freetserv/freetserv/BOM.txt

Qty Value            Part Num         Package               Parts                                                                                                                                                                                                                                                                                                                                                                                                                                                                                                       
1                    A1921-ND         1X02                  PWRIN                                                                                                                                                                                                                                                                                                                                                                                                                                                                                                       
95  0.1uF            1276-1003-1-ND   C0805                 C1, C4, C11, C12, C15, C16, C17, C18, C19, C22, C23, C24, C25, C26, C27, C28, C29, C30, C31, C32, C33, C34, C35, C36, C37, C38, C39, C40, C41, C42, C43, C44, C45, C46, C47, C54, C55, C56, C57, C58, C59, C60, C61, C62, C63, C64, C65, C66, C67, C68, C69, C70, C71, C72, C73, C74, C75, C76, C77, C78, C79, C80, C81, C89, C90, C91, C92, C93, C94, C95, C96, C97, C98, C99, C100, C101, C102, C103, C104, C105, C106, C107, C108, C109, C110, C111, C112, C113, C114, C115, C116, C489, C519, C859, C869
2   1.5K             311-1.5KARCT-ND  R0805                 R3, R6                                                                                                                                                                                                                                                                                                                                                                                                                                                                                                      
1   1uF              311-1365-1-ND    C0805                 C5                                                                                                                                                                                                                                                                                                                                                                                                                                                                                                          
3   3.3uF            445-7589-1-ND    C0805                 C8, C629, C829                                                                                                                                                                                                                                                                                                                                                                                                                                                                                              
6   4.7uF            1276-2972-1-ND   C0805                 C13, C14, C53, C502, C879, C889                                                                                                                                                                                                                                                                                                                                                                                                                                                                             
1   6MHz             535-10208-1-ND   CSM-7X-DU             Q2                                                                                                                                                                                                                                                                                                                                                                                                                                                                                                          
1   10k              311-10KARCT-ND   R0805                 R5                                                                                                                                                                                                                                                                                                                                                                                                                                                                                                          
4   10uF             490-10517-1-ND   C0805                 C2, C3, C6, C7                                                                                                                                                                                                                                                                                                                                                                                                                                                                                              
3   12K/1%           311-12.0KCRCT-ND R0805                 R2, R13, R15                                                                                                                                                                                                                                                                                                                                                                                                                                                                                                
1   15uH             587-2624-1-ND    NR60XX                L3                                                                                                                                                                                                                                                                                                                                                                                                                                                                                                          
2   18pF             709-1171-1-ND    C0805                 C20, C21                                                                                                                                                                                                                                                                                                                                                                                                                                                                                                    
1   22K              311-22KARCT-ND   R0805                 R7                                                                                                                                                                                                                                                                                                                                                                                                                                                                                                          
2   27               311-27ARCT-ND    R0805                 R1, R8                                                                                                                                                                                                                                                                                                                                                                                                                                                                                                      
1   27               Y2270CT-ND       EXBV4V                RN2                                                                                                                                                                                                                                                                                                                                                                                                                                                                                                         
1   31.6k            311-31.6KCRCT-ND R0805                 R4                                                                                                                                                                                                                                                                                                                                                                                                                                                                                                          
6   330              490-5988-1-ND    WE-KI_0805A           FB1, FB2, FB2\, FB2\1, FB2\2, FB3                                                                                                                                                                                                                                                                                                                                                                                                                                                                           
12  3232             296-19263-1-ND   SOP65P640X120-16N     IC5, IC6, IC7, IC8, IC10, IC11, IC12, IC13, IC15, IC16, IC17, IC18                                                                                                                                                                                                                                                                                                                                                                                                                                          
1   0446200001       *                0446200001            X1                                                                                                                                                                                                                                                                                                                                                                                                                                                                                                          
1   61300411021      732-5337-ND      61300411021           DAISY_OUT                                                                                                                                                                                                                                                                                                                                                                                                                                                                                                   
1   613004143121     732-2863-ND      613004143121          DAISY_IN                                                                                                                                                                                                                                                                                                                                                                                                                                                                                                    
1   ASFL1-12.000     535-9253-1-ND    XO53                  QG1                                                                                                                                                                                                                                                                                                                                                                                                                                                                                                         
3   FT4232HL         768-1026-1-ND    LQFP64                FTDI1, FTDI2, FTDI3                                                                                                                                                                                                                                                                                                                                                                                                                                                                                         
1   MCP16311         MCP16311-E/MS-ND MSOP8                 IC1                                                                                                                                                                                                                                                                                                                                                                                                                                                                                                         
2   MOUNT-HOLE3.2    *                3,2                   H1, H2                                                                                                                                                                                                                                                                                                                                                                                                                                                                                                      
2   SN65220          296-9694-1-ND    SOT23-6               D1, D2                                                                                                                                                                                                                                                                                                                                                                                                                                                                                                      
1   SS73100-046F_DWG 380-1225-ND      SS73100-046F          U$1                                                                                                                                                                                                                                                                                                                                                                                                                                                                                                         
1   TUSB2046BVF      TUSB2046BVF      QFP80P900X900X145-32N HUB                                                                                                                                                                                                                                                                                                                                                                                                                                                                                                         
1   USB_MICROB       H11634CT-ND      USB_MICROB_PACKAGE    USB_HOST
