freetserv/freetserv/(threads)

Thread 4 (2015-09-19):

increase spacing around U1 if possible

stapelberg, 2015-09-19:

stapelberg, 2015-09-26:
I think with #3 fixed, the spacing should be okay. Given that the design works fine (+5V goes in, +3.3V comes out), I’m a bit hesitant to change it unless absolutely necessary.

Closed 2015-09-26.

Thread 5 (2015-09-19):

swap TLV810 with TLV803, gets rid of the inverter

stapelberg, 2015-09-19:

stapelberg, 2015-09-22:
We’ll need a pull-up resistor for this.

stapelberg, 2015-09-26:
Or, even better, just use an R/C circuit, which saves half a euro per board (and one IC which is hard to solder).

Closed 2015-09-26.

Thread 12 (2015-09-22):

The 3 100nF capacitors near VCORE are missing (to clean the voltage)

stapelberg, 2015-09-22:

Closed 2015-09-28.

Thread 6 (2015-09-22):

Add resistors and capacitors for USB impedance

stapelberg, 2015-09-22:

stapelberg, 2015-09-28:
From http://www.ti.com/lit/ds/symlink/tusb2046b.pdf:

> All USB DP, DM signal pairs require series resistors of approximately 27Ω to ensure proper termination. An optional filter capacitor of about 22 pF is recommended for EMI suppression. This capacitor, if used, must be placed between the hub terminal and the series resistor, as per section 7.1.6 of the USB specification.

stapelberg, 2015-09-28:
Going to use 311-27.0CRCT-ND (RES SMD 27 OHM 1% 1/8W 0805)

Closed 2015-09-28.

Thread 15 (2015-09-24):

clone layout 3 more times once done

stapelberg, 2015-09-24:
Use https://github.com/esawdust/eagledroppings

stapelberg, 2015-09-24:
Use Eagle’s Hierarchical Design capabilities beforehand in the schematic so that it’s easier to understand the schematic, provided the free version can do that.

stapelberg, 2015-11-08:
This is done with commit 2a5ee336e396ece85858b84dca2a15ba39bcd74f

Closed 2015-11-08.

Thread 16 (2015-10-17):

Figure out a suitable 19" case

stapelberg, 2015-10-17:
Current candidates:

• [Rack case from RS](http://ch.rs-online.com/web/p/gehause-rackmontage/6657706/) (for 55 CHF), requires aluminium front panel processing
• [Schaeffer AG](http://www.schaeffer-ag.de/en/products/housings/) could make a case + front panel (or just a front panel, for the RS case?)

stapelberg, 2015-10-17:
We’ll also need a 5V/2A open frame power supply.

stapelberg, 2015-10-17:
[Delta Electronics PJ-5V15WBNA](http://www.digikey.ch/product-detail/de/PJ-5V15WBNA/1145-1060-ND/4386531) seems to be the best fit for an open frame power supply (5V 3A).

stapelberg, 2015-10-17:
Based on a bit of playing around with Schaeffer AG’s Frontplatten Designer, making a 19" case (with custom front panel and screw holes where we need them) costs about 200 €.

stapelberg, 2015-10-17:
To connect a power cable to the PSU, another device uses [the Delta 03KENG3EA](https://www.digikey.com/product-detail/en/03KENG3EA/1144-1118-ND/4379979), but I’m not sure if there isn’t a better choice.

stapelberg, 2015-11-09:
http://www.digikey.ch/product-detail/de/PJ-5V15WCNA/1145-1061-ND/4386532 is the enclosed version of the power supply mentioned above.

stapelberg, 2015-11-21:
Here’s what one needs to order at Schaeffer (as a note for me until we describe it on the website):

* 1 x file:back.fpd
* 1 x file:front.fpd
* 1 x file:top.fpd
* 1 x file:bottom.fpd
* 2 x GLGP1011 Seitenprofil 1, natur eloxiert, Länge: 150,0 mm
* 1 x GGMS1102 Montageset ISP/B3,0-ZI DIN 7982, weiß verzinkt
* 1 x GGWS0111 Gehäusewinkel (4 Stück), natur eloxiert

stapelberg, 2015-12-08:
1144-1140-ND (Delta 03GENW3E-R) is a power inlet which includes wires, which is a bit more convenient.

Closed 2015-12-24.

Thread 17 (2015-11-20):

wrong part/wrong package: QG1

stapelberg, 2015-11-20:
The actual part is too big to be soldered onto the board. Need to find a different part or fix the packaging.

Closed 2015-11-20.

Thread 18 (2015-11-21):

enhancement: use a different oscillator

stapelberg, 2015-11-21:
Currently, QG1 is a 12MHz SMD oscillator, which is rather expensive in this form factor (2.47€ at digikey) and hard to solder when hand-soldering. For the next revision, we should chose a bigger and less expensive oscillator.

Closed 2015-11-30.

Thread 20 (2015-11-25):

case: revision 2

stapelberg, 2015-11-25:
- [x] use the right deployment option for the PSU (the left one obscures the fan and the micro USB port)
- [x] move PSU 2cm to the right, so that the case’s left hole for the angle is not obscured. This implies moving the Raspberry Pi to the right.
- [x] ensure the PSU has 4mm safety distance from all components
- [x] fix dimensions for the power inlet (currently uses the *outer* dimensions, should use the “suggested mounting cut-out” dimensions from the [datasheet](http://www.deltaww.com/filecenter/Products/download/04/0406/iec_inlet_filter/KEN.pdf))
- [x] make case 2cm deeper so that the holes for the angles can be used.
- [x] ensure there are 16mm of space from the top of the PCBs, so that we could connect each one via USB in case daisy-chaining does not work.
- [x] in the front, move the space where the bottom/top slides into 1mm up/down (for bottom/front, respectively). This reduces the space in our case by 2mm, but makes sure that we can actually slide in the front/bottom plates, making the entire construction more robust.
- [x] add 2mm of material to the top/bottom plate, so that it can slide into the front panel
- [x] label the serial ports, label eth0
- [x] label power inlet with 230V / 15W (PSU specs)
- [x] move the third PCB 0.5mm to the left
- [x] move the second PCB 1mm to the left
- [x] move the first PCB 1.5mm to the left
- [x] check if it is easy to add a power LED
- [ ] use a side profile which is 20mm longer than previously

notes: 3.5mm of extra height is available in the case currently, but try to use only 3mm of extra height to play it safe. At the bottom, we have 2mm of space until the parts on the PCB touch the bottom of the case.

Closed 2015-11-27.

Thread 21 (2015-11-25):

document errate on website

stapelberg, 2015-11-25:
- [x] solder 8P8C ports onto first board
- [x] test all serial ports for sending/receiving
- [x] hook up boards to the raspberry pi, verify that it recognizes them
- [x] solder another board
- [x] test whether the daisy chaining works: it doesn’t. commit f99ddb0e3210b0f54aaaec5ce0b93b40c5a6e815 fixes it (hotfix is to solder a wire to the nearest GND)

stapelberg, 2015-12-19:
Closing this as we don’t need an errata section now — the only published version is 1.2.

Closed 2015-12-19.

Thread 22 (2015-11-25):

re-order missing/wrong parts

stapelberg, 2015-11-25:
- [ ] 5-position header for the PSU: 455-1186-ND
- [ ] 5V power LED: 67-1100-ND

stapelberg, 2015-11-29:
Ordered.

Closed 2015-11-29.

Thread 24 (2015-11-25):

clean up silkscreen

stapelberg, 2015-11-25:
The part names are not very useful when soldering, we should switch to values for capacitors and resistors.

We should also pay a lot more attention to where the labels end up — a number of labels are not visible on the current silkscreen.

stapelberg, 2015-11-30:
We also need to enable the tValues and bValues layer in the CAM job file.

Closed 2015-11-30.

Thread 26 (2015-12-06):

enhancement: create a header for the ethernet port

stapelberg, 2015-12-06:
We can just not populate it on 3 of the 4 boards.

jaredmauch, 2016-01-03:
I can tackle this one.  It's super simple.

stapelberg, 2016-01-04:
Great, looking forward to your pull request (please keep the changes as small as possible). Let me know if you need anything.

jaredmauch, 2016-01-04:
Well, I haven't completed it, but thought I'd ask your feelings on this placement first before I fix all the impacted traces, length matching, etc.

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

stapelberg, 2016-01-04:
Thanks for the preview. I think the general position is fine, especially since the daisy-chain connector on the right hand side does not need to be populated for the right-most board.

Here are a couple of thoughts:

* Is the part that you’re adding available on Digi-Key?
* Can you come up with a way to route it without touching any other traces to make this change as non-invasive as possible? It looks to me like it might be possible to use traces on the top layer that go from top to bottom on the right hand side of the PCB, all the way to P12.

jaredmauch, 2016-01-04:
Yes, it's available on Digikey (WM5467-ND) and there are other variants which are more expensive or cheaper, eg: WM5468-ND which are pin compatible.  It's not really possible without moving part D2, which I assume is ok.  The traces related to D2 have to be re-routed.  This would obviously impact anyone using a PnP machine to place parts.

Is there a common .lbr file for freetserv I should put these parts in, or should that go in the pull?  I could also just email you the files offline.

stapelberg, 2016-01-04:
Moving D2 is okay. We don’t have a common .lbr file yet, but you’re welcome to start one, or just let Eagle embed the lbr file into the brd/sch files as appropriate (which is what we currently do).

jaredmauch, 2016-03-03:
taking a fresh look at this, i'm concerned that having the ethernet pin 5 shared with the RS232 ground may cause signal issues, have you had issues with the soldered cable connection being shared with the uart12 level shifter?

jaredmauch, 2019-12-18:
since this was merged, should this be closed?

stapelberg, 2019-12-19:
Yep, thanks

paravoid, 2020-12-20:
I've noticed that the documentation (assembly.html) still documents a manual way, and references this issue as a work-in-progress. Not sure how this should be updated though.

stapelberg, 2020-12-20:
@jaredmauch Any thoughts on this? Personally, I don’t have a build with the new ethernet port solution, and don’t plan on building one right now.

Closed 2019-12-19.

Thread 27 (2015-12-07):

case: top plate has cut-outs the wrong way around

stapelberg, 2015-12-07:
…that’s important because the screw holes are sunk, and it doesn’t look as good as-is ;)

Closed 2015-12-07.

Thread 29 (2015-12-07):

case: front panel is too thick for the power filter to snap in

stapelberg, 2015-12-07:
According to [the datasheet](http://www.deltaww.com/filecenter/Products/download/04/0406/iec_inlet_filter/KEN.pdf), we’ll need to cut out 1.5mm worth of aluminum for about 1mm at the top and bottom each.

stapelberg, 2015-12-08:
To fix it, we can drill a 4.5mm (height) x 23mm (width) x (3-1.2)mm (depth) rectangle at the top and bottom of the inlet cutout hole.

One other thing to investigate is to use an inlet that is secured by screws instead of a snap-in one — we have the space, and using screws should be more reliable.

Closed 2015-12-10.

Thread 30 (2015-12-07):

case: LED shows out too much

stapelberg, 2015-12-07:
We should probably switch to an SMD LED and add a relatively flat diffusor or something. As-is, when you place the case such that the LED is on the bottom, all the weight is on the LED, which makes it hard to fix the LED with hot glue.

stapelberg, 2015-12-11:
A 3.3kΩ with 1497-1017-ND (3.3V LED) seems to work pretty well in terms of brightness and current (<10mA, so should be okay for the Raspberry Pi’s GPIO).

stapelberg, 2015-12-11:
We should change the case to be 1mm less thick where the LEDs are, though, so that the shorter LEDs can actually go through the hole.

Thread 31 (2015-12-07):

Document raspberry pi set up on the website

stapelberg, 2015-12-07:
* [x] install the usual programs for serial port access (cu, minicom, screen, what else? check alix history)
* [x] make the system read-only
* [x] disable DHCP for IPv4, the device is going to be IPv6-only
* [x] set up permissions for ports via udev rules. see issue #25
* [x] recommend users to use the “from” directive in their `~/.ssh/authorized_keys`, to limit logins to certain IP addresses
* [x] watchdog LED: add configuration which will configure GPIO4 as an output and make it blink, signaling that the device is still alive. GPIO4 is a good choice because it is right next to GND, see http://www.raspberrypi-spy.co.uk/2012/06/simple-guide-to-the-rpi-gpio-header-and-pins/. With http://int03.co.uk/blog/2015/01/11/raspberry-pi-gpio-states-at-boot-time/, we might be able to configure it as a high output by default
* [x] MOTD file

Closed 2015-12-24.

Thread 33 (2015-12-08):

case: bottom plate’s holes are sunk the wrong way

stapelberg, 2015-12-08:
Need to place them on the backside of the plate.

Closed 2015-12-10.

Thread 34 (2015-12-09):

nit: figure out if we can change the schematics in such a way that the daisy_in on the last board can be disabled

stapelberg, 2015-12-09:
Currently, there is a USB enumeration error in the syslog, which comes from the fact that one USB device is not connected. I wonder if we can get rid of that easily.

Thread 35 (2015-12-24):

nit: find correctly colored cable (green/yellow) for grounding

stapelberg, 2015-12-24:
Currently, we use Digi-Key A119543-ND, but that doesn’t have the right color. Find a cable with the correct size and color.

athompso, 2019-07-15:
As of 2019jul15, DigiKey has 38 options to choose from that are "Normally Stocking":  https://www.digikey.com/products/en/cables-wires/single-conductor-cables-hook-up-wire/474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

The problem is that they all start at 100' (30m).

I checked Mouser, and they have the same problem - lots of options https://www.mouser.ca/Wire-Cable/Hook-up-Wire/_/N-5ggsZscv7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|0 assuming you want 100' or more.

Any local electronic or auto-parts supply store will have similar options; in the auto industry this is "primary wire", and often comes in rolls as small as 25'.  Or, just ask your local mechanic for a length of 18ga, green primary wire and it'll probably be free.  (Note that primary wire is often solid copper, though, not stranded.)
Higher gauges are usually OK for a grounding wire, and that increases your options, for example anywhere in Canada you can order this ridiculously cheaply: https://www.princessauto.com/en/detail/16-gauge-25-ft-green-primary-wire/A-p8216475e

If in the USA, you can find this nearby: https://www.homedepot.com/p/Southwire-25-ft-16-Green-Stranded-CU-GPT-Primary-Auto-Wire-56422021/202316507

I've no idea what to get in Europe, but I'm sure something similar exists - certainly mechanics and electricians are not noticeably more rare there than here in Canada, so shops must exist to service them.

I hate to encourage bad practice, but it would probably be cheaper and easier to destroy a standard PC power lead and scavenge 3ft of green-jacketed, stranded-copper, ground wire from that :-(.

athompso, 2019-07-15:
Also viable, but PITA: wrap colored electrical tape around the wire and/or use green heat-shrink tubing.

stapelberg, 2019-07-16:
Thanks for the details, that’s very helpful!

Thread 37 (2015-12-29):

Case redesign suggestions

alexandrujuncu, 2015-12-29:
Hi!

Just throwing in a couple of cents on the hardware design, if you find it helpful:
1) From what I understand from the pictures, it looks like the first RJ45 port is actually an Ethernet port while all the others are serial ones. This is both confusing and dangerous if somebody confuses the ports might end up burning the port (serial and Ethernet are not electrically friendly and I've seen a lot of people destroying ports because they plugged in the wrong one).
I think the Ethernet port should be clearly separated from the others. Also it might be better to NOT use an extender and just have the RJ45 port from the RPI directly accessible. Which brings me to the next point...
2) The Raspberry Pi board should not be the middle of the box, but at the edge accessible to the user. This way the side with the RJ port and the 2/4 USB ports would be accessible to the use. The USB ports could be used for miscellaneous things for the user so why not expose them?
But where to pace it? It will take up some room in the front. So the logical solution is instead of the power plug. And, again, this brings me to another point:
3) The power plug should not be in the front. I have seen many racks with many routers, switches and servers and with very few exceptions (I remember some annoying Cisco ASA/PIX-s) equipment has the power plug in the back. As it should. Power is provided through the back to be consistent with the rest of the equipment and also not block rack door from closing (power plugs tend to take up more room).

So, in conclusion, I suggest you put the Raspberry Pi on the left of the console ports, in the front. This way you would separate the Ethernet port from the serial ports and have direct access to the Ethernet and USB ports on the board itself. The big power plug could and _should_ be put in the back where it belongs and not get in the way of anything else.

Hope this helps. Thanks!

stapelberg, 2015-12-29:
The front side of freetserv has the serial ports and the power plug on the same side because servers do the same thing (see e.g. https://images.stockinthechannel.com/pic/-pie3aUTqUmBmdYcnONR9A.c-o.jpg). This leads to all the cables being on the same side of the rack, i.e. less clutter and less long cables.

If one wants to go for a case where some parts are on the front side and some are on the back side, I think it’d be reasonable to place the Raspberry Pi’s ports facing the back side, so that one gets the benefits of having the Ethernet port directly accessible that you mentioned. One tiny side node on the USB ports, though: freetserv is intended to be a single-purpose device, so there shouldn’t be a need to use the USB ports, or at least not in any user-facing fashion.

In general, I don’t have strong feelings on the way the case is designed. The current design works very well for the use-case that I’m solving for myself, and I’m publishing the files because they’re tested and found working. If other people have other use-cases/preferences, they’re welcome to modify the fpd files before ordering the case (or build an entirely new case altogether), and I’m happy to accept these modifications to live in the same repository. The only thing I ask is that such modifications are actually tested, and not just theoretical :).

I’ll close this issue as nothing remains to be done, at least not from my side. Thanks for your input!

alexandrujuncu, 2015-12-30:
Hi!

That image is actually actually backs the idea that power plugs should be at the back :-?

I've never worked with software to design hardware, so I might not be the right person for that.
But, perhaps, if you leave the issue open, someone in the community has the skills to do it.

Thanks!

stapelberg, 2015-12-30:
I think you are making the assumption that freetserv gets plugged into the front of the rack, i.e. the side where all the server LEDs are. The idea is to plug it into the back of the rack, though, where all the serial console ports, network cables and power cables are. Hence, freetserv’s front side is in the rack’s back side. I can add an actual picture of our rack in the next weeks.

Closed 2015-12-29.

Thread 40 (2016-06-15):

PCB fab details

rich86, 2016-06-15:
I have never had a PCB fabbed before, nor do I have the requisite software to open and view the files, for people like me, it would be helpful if there could be a little bit more hand-holding whilst ordering from from Smart Prototyping - I haven't yet placed an order because I'm not sure of which options I need to change.

A screenshot or a list of options on the materials.html would be very useful.

Also, are there any obvious gotchas that people should be aware of if they order from another fab, such as OSH Park?

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

stapelberg, 2016-06-22:
Thanks for your interest in the project.

> I have never had a PCB fabbed before, nor do I have the requisite software to open and view the files, for people like me, it would be helpful if there could be a little bit more hand-holding whilst ordering from from Smart Prototyping - I haven't yet placed an order because I'm not sure of which options I need to change.

If you have never had a PCB fabbed, I have to ask: are you aware that SMD soldering is not a trivial task? If you haven’t done it before, you should definitely get a bunch of starter kits and train. The critical components on freetserv are 4 bucks a piece (for the FTDI), and messing up one of them will very likely render the entire board unuseable, which is a big waste of money and source of frustration :).

With that out of the way, here are the parameters I used:

```
PCB Prototyping
  - Quantity: 10
  - Max X-Dimension (cm): 10
  - Max Y-Dimension (cm): 10
  - Layers: 2
  - PCB Thickness (mm): 1.6
  - Copper Thickness: 1 oz
  - Surface Finish: HASL (Hot Air Solder..
  - Solder Mask Color: Green
  - E-Test Pass: 100%
  - Solder Paste Stencil: no
  - Separated Sub-Boards: no
  - Lead Time: Normal
  - Gerber Files(zip or rar): gerber.zip
```

So, everything left to the default setting, except for the E-test being raised to 100% and the X/Y dimension adjusted because our PCB is bigger than 5cm x 5cm.

Hope that helps.

paravoid, 2020-12-20:
Piggybacking on this issue… a good option would be to use JLCPCB's SMT assembly service. I spot-checked a lot of the ICs and they all seem to be in their SMT parts library. The exact part numbers for some of the more standard components (capacitors etc.) don't match, but of course replacements exist. It shouldn't be too hard to create a BOM!

Note that they currently don't support connectors (like USB) but that's supposedely imminent. They also do not support through-hole components, but these are also easier to solder. Just having all the SMT components sourced and soldered would lower the bar here considerably IMHO :)

paravoid, 2020-12-20:
So I looked into it a bit more: 5 components (incl. the FT4232 and MAX3232) are available and 13 have a direct replacement from another vendor (same characteristics/package). On the flip side, 4 don't have a direct replacement (ferrite beads, 6MHz crystal, resistor array, HC-49/US inductor), 5 are through-hole components (RJ45 jacks, and board-to-board connectors) that are not supported but are also easy to solder, plus one SMT connector (microUSB) that is rumoured to be soon available for assembly.

More importantly though… JLCPCB's service doesn't support SMT assembly on both sides of the PCB, and the current design has the components almost equally split between the two sides as far as I can tell. So unless they add support for two-sided assembly, or someone is willing to go through the pain of a PCB redesign here, I don't see a lot of value in pursuing this further…

Thread 41 (2016-10-08):

Wrong Digikey Part for QG1

jhorisberger, 2016-10-08:
The 12MHz Oscilator in the BOM from eagle and on the Homepage dos not fit the footprint on the PCB. From the Silkscreen on the PCB i gather that it should be form the ASFL1 series (instead of ASV). I found this part:  Abracon LLC ASFL1-12.000MHZ-EK-T (535-9253-1-ND ) which I think should be ok? (almost identical specs and right footprint)

stapelberg, 2016-10-19:
Thanks for reporting this. I just had a chance to check my inbox for orders, and indeed I did order the 535-9253-1-ND after I must have realized that the other oscillator has the wrong form factor :).

I’ll fix this in a second.

Closed 2016-10-19.

Thread 42 (2017-08-20):

BOM DAISY_IN Digi-Key Part 732-2863-ND is a 10 pin Header

lairsdragon, 2017-08-20:
Hi

The Digi-Key Part Number 732-2863-ND is a 10 pin Header. The Wurth Elektronik part number in the BOM.txt is correct but I was not able to find that part at Digi-Key.

The Wurth Elektronik part number on the  website (in fts-bom-pcbparts.html) is wrong.

cheerio
    Steve

stapelberg, 2017-08-20:
Thanks! This is now fixed.

lairsdragon, 2017-08-20:
Hi Michael

The Digi-Key Part Number points still to a 10 pin Header;

cheerio
    Steve

stapelberg, 2017-08-20:
I can’t find a more suitable part number on Digi-Key. You can easily cut the 10-pin connector to be a 4-pin connector, so it’s no big deal. If you have a better part number, let me know.

Closed 2017-08-20.

Thread 43 (2018-09-16):

known issue: some serial ports are broken on my build

stapelberg, 2018-09-16:
Out of the 47 serial ports, 3 don’t give any signal when connecting devices:

- port 24
- port 43
- port 45

This might well be a problem with my soldering, but I figured it makes sense to document it here. Unfortunately, I lack the opportunity to debug this particular build.

Thread 44 (2018-09-16):

known issue: sometimes, all ports stop working until a reboot

stapelberg, 2018-09-16:
I ran into this situation twice (I think) with my one build.

At a certain time — I’m not sure when — all ports stop working. The FTDI driver prints messages to syslog, but unloading and reloading the driver seems to have no effect.

Rebooting the device seems to help. I haven’t tried reloading the USB stack, as the issue is so rare.

Thread 46 (2020-05-15):

udev rules not working on Raspi 4

r-schmidt, 2020-05-15:
On the Raspi 2 the USB ports were identified as platform-bcm2708_usb-usb-[0-9] in freetserv.rules.
The Raspi 4 is a different platform so that fails. Instead the name is now platform-fd500000.pcie-pci-0000:01:00.0-usb-[0-9].

I made a little script that creates the rules file from a template:

`#!/bin/sh`

`rules_template_file="/usr/local/freetserv/freetserv.rules.template"`
`rules_file="/etc/udev/rules.d/freetserv.rules"`

`# create udev rules based on template file:`
`# find the ID of the USB port the PCBs are connected to`
`pcb_usb_port=$(udevadm test-builtin path_id /sys/class/tty/ttyUSB0 | grep -Po 'ID_PATH=\K.*usb-[0-9]?')`

`sed "s/FREETSERV_USB_PORT/$pcb_usb_port/g" "$rules_template_file" > "$rules_file"`

` # trigger update of the device name symlinks`
` for i in $(seq 0 47); do udevadm test $(udevadm info -q path -n /dev/ttyUSB$i) >/dev/null 2>&1; done`

The template is simply the existing freetserv.rules file where `platform-bcm2708_usb-usb-[0-9]`
if replaced with `FREETSERV_USB_PORT` which the script then replaces with the actual port.

stapelberg, 2020-05-15:
Thanks for filing this. Could you send a pull request which updates https://github.com/freetserv/freetserv/blob/05c33bea87f1ace5e6dc063f59996f533559ec67/udev/freetserv.rules please? I don’t mind duplication in there, and the file changes rarely.

By the way: did you build a freetserv instance? How is everything working out for you?

stapelberg, 2020-05-15:
This is fixed with pull request PR #47

r-schmidt, 2020-05-15:
I'm totally new to Github so I hope I did the pull request right (or not completely wrong...).

My freetserv instance is quite different because the use case is very different:
I have shelves (with line cards) with serial ports from every slot combined into ribbon cables (12 slots per cable) for debugging.
So the PCB was modified with a pin header for the ribbon cable which connects to the different RJ45 soldering points and the RJ45 sockets are not assembled.
The front plate only contains one RJ45 socket for the Ethernet of the Raspi, a LED to see that power is on, power connector and a power switch.
The back plate has openings for 4 ribbon cables so I can connect 2 fully equipped shelves (48 slots).
The case is a really cheap plastic one: https://www.reichelt.de/19-rack-gehaeuse-1-he-abs-schwarz-rnd-455-00114-p193326.html?&trstct=pol_1&nbc=1
The front and back plate are replaced with 3D-printed ones for the connectors and switch (could also make holes in the existing plates but printing is cool...).

On the raspi I used raspian (Debian is not there yet for proper out of the box use on raspi 4).
There is a single passwordless user that all telnet connections log into. The serial port is selected by giving the name to telnet as user name (parameter -l) instead of the port number like in the commercial terminal servers.
I had to change /etc/pam.d/common-auth to allow login without password (nullok instead of nullok_secure).

Using SSH would have meant to provide everyone with the same private key or add many public keys to the user. Or have many users like what you use which is also not feasible for us.
It is a development tool and which slot is used by whom can change multiple times per day and there are also multiple users looking at the same port.

After login the provided username is used to select which screen instance to attach to. This makes management really simple.
And it allows to use aliases for the ports without having to add more symlinks via udev.
I'm not completely done with that yet (e.g. managing aliases with a simple management interface is on the todo list).

stapelberg, 2020-05-15:
Sounds great, thanks for sharing! Do you have any pictures? I’m glad to learn that freetserv was useful for your project.

Your pull request was fine, too! :)

Closed 2020-05-15.

Thread 48 (2020-12-16):

using more than 34 ports at the same time crashes the kernel

r-schmidt, 2020-12-16:
This is obviously a bug/limitation in Linux but I just wanted to mention it here.
I'm using screen to access the serial ports and leave the sessions running so I can re-attach later.
Now I saw that the moment I create the 35th session, the kernel crashes.
It doesn't matter which port the session is created for.

I'm using the latest Raspberry Pi OS on a Raspi 4B with 2GB RAM and the issue is reproducible every time and on all of my 48 port freetservs.

I was just wondering if you also see that on your system that unless you changed it is running a Debian?

stapelberg, 2020-12-16:
Thanks for documenting this issue.

I haven’t run into this myself because we never had that many sessions on freetserv.

Perhaps you can raise this on the Linux kernel mailing list and see if anyone can help there?

raylee, 2020-12-16:
@r-schmidt could you post the kernel's oops message from the crash? Even an image would be helpful, though the complete oops in text form is preferred. You'll want that for posting to the linux kernel mailing list regardless.

r-schmidt, 2020-12-17:
Ok, here is what is coming on the console (there is more coming every ~30 seconds but that is probably irrelevant).
I haven't tried connecting the ports to a different computer (e.g. my notebook) to see if it happens there as well.
Will maybe do that later today.

[  103.715803] 8<--- cut here ---
[  103.720089] Unhandled fault: asynchronous external abort (0x1211) at 0x00000000
[  103.728619] pgd = d30b99fe
[  103.732532] [00000000] *pgd=17787003, *pmd=00000000
[  103.738634] Internal error: : 1211 [#1] SMP ARM
[  103.744388] Modules linked in: sha256_generic libsha256 cfg80211 rfkill 8021q garp stp llc ftdi_sio usbserial vc4 cec rpivid_mem v3d drm_kms_helper gpu_sched drm bcm2835_codec(C) bcm2835_v4l2(C) bcm2835_isp(C) v4l2_mem2mem bcm2835_mmal_vchiq(C) videobuf2_dma_contig videobuf2_vmalloc videobuf2_memops videobuf2_v4l2 videobuf2_common drm_panel_orientation_quirks raspberrypi_hwmon snd_soc_core videodev mc vc_sm_cma(C) snd_compress snd_pcm_dmaengine snd_pcm snd_timer snd syscopyarea sysfillrect sysimgblt fb_sys_fops uio_pdrv_genirq uio ip_tables x_tables ipv6
[  103.797884] CPU: 0 PID: 2336 Comm: sudo Tainted: G         C        5.4.79-v7l+ #1373
[  103.807232] Hardware name: BCM2711
[  103.812161] PC is at lockref_put_return+0x50/0x9c
[  103.818379] LR is at dput.part.8+0x58/0x3b8
[  103.824052] pc : [<c06a2f98>]    lr : [<c04287c0>]    psr: 60000013
[  103.831839] sp : d6dbbe50  ip : 00000000  fp : d6dbbe6c
[  103.838602] r10: d71f8c70  r9 : 00000001  r8 : 00080060
[  103.845375] r7 : 00000001  r6 : 00030003  r5 : 00000000  r4 : 00030003
[  103.853475] r3 : 00000001  r2 : 00030003  r1 : 00000064  r0 : d91b1fb8
[  103.861570] Flags: nZCv  IRQs on  FIQs on  Mode SVC_32  ISA ARM  Segment user
[  103.870286] Control: 30c5383d  Table: 177ea000  DAC: fffffffd
[  103.877630] Process sudo (pid: 2336, stack limit = 0xb7a13c6b)
[  103.885085] Stack: (0xd6dbbe50 to 0xd6dbc000)
[  103.891075] be40:                                     d91b1f68 d91b1fb8 c0de3628 00080040
[  103.900914] be60: d6dbbea4 d6dbbe70 c04287c0 c06a2f54 00000000 c040e3bc 00000000 d6c58180
[  103.910762] be80: d71f8c70 080a801d ef32e850 d91b1f68 00000010 d71f8c70 d6dbbeb4 d6dbbea8
[  103.920635] bea0: c0428b38 c0428774 d6dbbef4 d6dbbeb8 c040e42c c0428b2c 00000000 00000000
[  103.930523] bec0: c020ce54 d6c58188 d6d0eff0 d6c58180 00000000 d6d0eac0 d6d0f01c c12b9d54
[  103.940423] bee0: d6d0eff0 c1204fc8 d6dbbf04 d6dbbef8 c040e59c c040e34c d6dbbf2c d6dbbf08
[  103.950351] bf00: c02433f8 c040e590 ffffe000 d6dbbfb0 c02011c4 00000004 fffffe30 5ac3c35a
[  103.960296] bf20: d6dbbfac d6dbbf30 c020ce54 c0243350 d6dbbf4c d6dbbf40 5ac3c35a c1204fcc
[  103.970269] bf40: d6dbbf6c d6dbbf50 c0407de8 c040eb18 00000004 d6d60600 d7a73c00 00000000
[  103.980258] bf60: d6dbbf94 d6dbbf70 c042fcc0 c0407d84 02008150 b6e63b1c 00000000 8dd7b910
[  103.990263] bf80: c02011c4 02008150 b6e63b1c 00000000 00000006 c02011c4 d6dba000 00000006
[  104.000294] bfa0: 00000000 d6dbbfb0 c0201034 c020c8cc 00000000 00000444 b6e636d8 b6d83864
[  104.010348] bfc0: 02008150 b6e63b1c 00000000 00000006 b66ff29c b66ff298 020082b8 00000000
[  104.020416] bfe0: 00000000 bef0ef68 b6d85088 b6de8f74 20000010 00000004 00000000 00000000
[  104.030494] Backtrace:
[  104.034839] [<c06a2f48>] (lockref_put_return) from [<c04287c0>] (dput.part.8+0x58/0x3b8)
[  104.044880]  r7:00080040 r6:c0de3628 r5:d91b1fb8 r4:d91b1f68
[  104.052509] [<c0428768>] (dput.part.8) from [<c0428b38>] (dput+0x18/0x1c)
[  104.061293]  r10:d71f8c70 r9:00000010 r8:d91b1f68 r7:ef32e850 r6:080a801d r5:d71f8c70
[  104.071136]  r4:d6c58180
[  104.075682] [<c0428b20>] (dput) from [<c040e42c>] (__fput+0xec/0x244)
[  104.084163] [<c040e340>] (__fput) from [<c040e59c>] (____fput+0x18/0x1c)
[  104.092917]  r10:c1204fc8 r9:d6d0eff0 r8:c12b9d54 r7:d6d0f01c r6:d6d0eac0 r5:00000000
[  104.102826]  r4:d6c58180
[  104.107432] [<c040e584>] (____fput) from [<c02433f8>] (task_work_run+0xb4/0xd4)
[  104.116843] [<c0243344>] (task_work_run) from [<c020ce54>] (do_work_pending+0x594/0x59c)
[  104.127050]  r9:5ac3c35a r8:fffffe30 r7:00000004 r6:c02011c4 r5:d6dbbfb0 r4:ffffe000
[  104.136925] [<c020c8c0>] (do_work_pending) from [<c0201034>] (slow_work_pending+0xc/0x20)
[  104.147255] Exception stack(0xd6dbbfb0 to 0xd6dbbff8)
[  104.154468] bfa0:                                     00000000 00000444 b6e636d8 b6d83864
[  104.164831] bfc0: 02008150 b6e63b1c 00000000 00000006 b66ff29c b66ff298 020082b8 00000000
[  104.175197] bfe0: 00000000 bef0ef68 b6d85088 b6de8f74 20000010 00000004
[  104.184017]  r10:00000006 r9:d6dba000 r8:c02011c4 r7:00000006 r6:00000000 r5:b6e63b1c
[  104.194070]  r4:02008150
[  104.198818] Code: 1a000002 e1a0cf94 e33c0000 1afffff8 (e1570003)
[  104.207145] ---[ end trace e5ed96736c0aa23a ]---
[  104.214070] pcieport 0000:00:00.0: AER: Multiple Uncorrected (Non-Fatal) error received: 0000:00:00.0
[  105.586945] ------------[ cut here ]------------
[  105.593927] WARNING: CPU: 2 PID: 131 at drivers/firmware/raspberrypi.c:63 rpi_firmware_transaction+0xec/0x128
[  105.606193] Firmware transaction timeout
[  105.606196] Modules linked in: sha256_generic libsha256 cfg80211 rfkill 8021q garp stp llc ftdi_sio usbserial vc4 cec rpivid_mem v3d drm_kms_helper gpu_sched drm bcm2835_codec(C) bcm2835_v4l2(C) bcm2835_isp(C) v4l2_mem2mem bcm2835_mmal_vchiq(C) videobuf2_dma_contig videobuf2_vmalloc videobuf2_memops videobuf2_v4l2 videobuf2_common drm_panel_orientation_quirks raspberrypi_hwmon snd_soc_core videodev mc vc_sm_cma(C) snd_compress snd_pcm_dmaengine snd_pcm snd_timer snd syscopyarea sysfillrect sysimgblt fb_sys_fops uio_pdrv_genirq uio ip_tables x_tables ipv6
[  105.669241] CPU: 2 PID: 131 Comm: kworker/2:3 Tainted: G      D  C        5.4.79-v7l+ #1373
[  105.680175] Hardware name: BCM2711
[  105.686158] Workqueue: events get_values_poll [raspberrypi_hwmon]
[  105.694845] Backtrace:
[  105.699878] [<c020dfb0>] (dump_backtrace) from [<c020e334>] (show_stack+0x20/0x24)
[  105.710075]  r7:ffffffff r6:00000000 r5:60000013 r4:c129fab0
[  105.718362] [<c020e314>] (show_stack) from [<c0a76254>] (dump_stack+0xd8/0x11c)
[  105.728314] [<c0a7617c>] (dump_stack) from [<c0222028>] (__warn+0xe0/0x108)
[  105.737905]  r10:dec12008 r9:00000009 r8:c08dd810 r7:0000003f r6:00000009 r5:c08dd810
[  105.748380]  r4:c0e3a554 r3:00000000
[  105.754599] [<c0221f48>] (__warn) from [<c0222424>] (warn_slowpath_fmt+0xa4/0xc0)
[  105.764755]  r7:0000003f r6:c0e3a554 r5:c1204fc8 r4:c0e3a574
[  105.773087] [<c0222384>] (warn_slowpath_fmt) from [<c08dd810>] (rpi_firmware_transaction+0xec/0x128)
[  105.784913]  r9:efa10440 r8:00000010 r7:00000000 r6:ffffff92 r5:efa10440 r4:c1204fc8
[  105.795361] [<c08dd724>] (rpi_firmware_transaction) from [<c08dd908>] (rpi_firmware_property_list+0xbc/0x170)
[  105.808010]  r7:c1204fc8 r6:dec12000 r5:00001000 r4:dec1201c
[  105.816340] [<c08dd84c>] (rpi_firmware_property_list) from [<c08dda2c>] (rpi_firmware_property+0x70/0x118)
[  105.828626]  r10:d6da2bcc r9:00030046 r8:00000010 r7:efa10440 r6:d8b8bee0 r5:00000004
[  105.839032]  r4:d6da2bc0
[  105.844114] [<c08dd9bc>] (rpi_firmware_property) from [<bf0710c0>] (get_values_poll+0x4c/0x150 [raspberrypi_hwmon])
[  105.857144]  r10:00000000 r9:00000080 r8:00000000 r7:eff3e600 r6:eff3b300 r5:d87a1a4c
[  105.867582]  r4:c1204fc8 r3:00000004
[  105.873766] [<bf071074>] (get_values_poll [raspberrypi_hwmon]) from [<c023e884>] (process_one_work+0x250/0x570)
[  105.886507]  r5:d8be6300 r4:d87a1a4c
[  105.892720] [<c023e634>] (process_one_work) from [<c023ec04>] (worker_thread+0x60/0x5d0)
[  105.903490]  r10:eff3b300 r9:c1203d00 r8:eff3b318 r7:00000008 r6:eff3b300 r5:d8be6314
[  105.914007]  r4:d8be6300
[  105.919233] [<c023eba4>] (worker_thread) from [<c0245fd0>] (kthread+0x170/0x174)
[  105.929334]  r10:ef939e74 r9:c023eba4 r8:d8be6300 r7:d8b8a000 r6:00000000 r5:d8c63b80
[  105.939872]  r4:d8c63800
[  105.945104] [<c0245e60>] (kthread) from [<c02010ac>] (ret_from_fork+0x14/0x28)
[  105.955050] Exception stack(0xd8b8bfb0 to 0xd8b8bff8)
[  105.962811] bfa0:                                     00000000 00000000 00000000 00000000
[  105.973718] bfc0: 00000000 00000000 00000000 00000000 00000000 00000000 00000000 00000000
[  105.984616] bfe0: 00000000 00000000 00000000 00000000 00000013 00000000
[  105.993925]  r10:00000000 r9:00000000 r8:00000000 r7:00000000 r6:00000000 r5:c0245e60
[  106.004444]  r4:d8c63b80
[  106.009681] ---[ end trace e5ed96736c0aa23b ]---
[  106.017184] hwmon hwmon1: Failed to get throttled (-110)
[  115.025715] sched: RT throttling activated
[  115.025783] pcieport 0000:00:00.0: AER: PCIe Bus Error: severity=Uncorrected (Non-Fatal), type=Transaction Layer, (Requester ID)
[  115.046856] pcieport 0000:00:00.0: AER:   device [14e4:2711] error status/mask=00004000/00000000
[  115.058368] pcieport 0000:00:00.0: AER:    [14] CmpltTO                (First)
[  115.072822] 8<--- cut here ---
[  115.072914] pcieport 0000:00:00.0: AER: Device recovery failed
[  115.078604] Unhandled fault: asynchronous external abort (0x1211) at 0x00000000
[  115.078611] pgd = 275d29b4
[  115.078615] [00000000] *pgd=17685003, *pmd=7fe40003
[  115.078628] Internal error: : 1211 [#2] SMP ARM
[  115.087180] pcieport 0000:00:00.0: AER: Uncorrected (Non-Fatal) error received: 0000:00:00.0
[  115.097149] Modules linked in: sha256_generic libsha256 cfg80211 rfkill 8021q garp stp llc ftdi_sio usbserial vc4 cec rpivid_mem v3d drm_kms_helper gpu_sched drm bcm2835_codec(C) bcm2835_v4l2(C) bcm2835_isp(C) v4l2_mem2mem bcm2835_mmal_vchiq(C) videobuf2_dma_contig videobuf2_vmalloc videobuf2_memops videobuf2_v4l2 videobuf2_common drm_panel_orientation_quirks raspberrypi_hwmon snd_soc_core videodev mc vc_sm_cma(C) snd_compress snd_pcm_dmaengine snd_pcm snd_timer snd syscopyarea sysfillrect sysimgblt fb_sys_fops uio_pdrv_genirq uio ip_tables x_tables ipv6
[  115.102550] pcieport 0000:00:00.0: AER: PCIe Bus Error: severity=Uncorrected (Non-Fatal), type=Transaction Layer, (Requester ID)
[  115.110065] CPU: 2 PID: 2332 Comm: screen Tainted: G      D WC        5.4.79-v7l+ #1373
[  115.110069] Hardware name: BCM2711
[  115.110079] PC is at xhci_urb_dequeue+0xd8/0x474
[  115.110084] LR is at 0xefb901a8
[  115.117270] pcieport 0000:00:00.0: AER:   device [14e4:2711] error status/mask=00004000/00000000
[  115.128351] pc : [<c08361b4>]    lr : [<efb901a8>]    psr: 80000093
[  115.128355] sp : d772faf0  ip : 00000000  fp : d772fb44
[  115.128359] r10: 20000013  r9 : 00000000  r8 : efb901a0
[  115.128365] r7 : efb90000  r6 : d6da2c00  r5 : efb90000  r4 : d75316c0
[  115.185903] pcieport 0000:00:00.0: AER:    [14] CmpltTO                (First)
[  115.200336] r3 : deaddead  r2 : 00000000  r1 : 0000000e  r0 : d84da280
[  115.200342] Flags: Nzcv  IRQs off  FIQs on  Mode SVC_32  ISA ARM  Segment user
[  115.200346] Control: 30c5383d  Table: 16da2000  DAC: 55555555
[  115.200353] Process screen (pid: 2332, stack limit = 0xad38c8bd)
[  115.211299] pcieport 0000:00:00.0: AER: Device recovery failed
[  115.217488] Stack: (0xd772faf0 to 0xd7730000)
[  115.217494] fae0:                                     c020bc44 c020cf3c c020bc44 00000000
[  115.217501] fb00: c081e91c c10a8b10 c0a95480 efb90170 d8171000 00000000 00001388 d75316c0
[  115.217507] fb20: 60000013 efb90000 fffffffe d772fc18 00001388 d6da20c0 d772fb6c d772fb48
[  115.225819] 8<--- cut here ---
[  115.231000] fb40: c081cf3c c08360e8 d75316c0 60000013 d87c4000 fffffffe d772fc18 00001388
[  115.242694] Unhandled fault: asynchronous external abort (0x1211) at 0x00000000
[  115.251811] fb60: d772fb8c d772fb70 c081e930 c081cf0c d75316c0 c1204fc8 d75316d0 d772fbc8
[  115.259867] pgd = 6f1d3327
[  115.267897] fb80: d772fbc4 d772fb90 c0820078 c081e8c4 c025249c 00000100 00000122 8dd7b910
[  115.277222] [00000000] *pgd=1806c003, *pmd=7fcd9003
[  115.287249] fba0: d75316c0 8dd7b910 d75316c0 c1204fc8 00000000 d772fbc8 d772fc04 d772fbc8
[  115.445710] fbc0: c0820760 c082000c 00000000 00020002 d772fbd0 d772fbd0 00000003 8dd7b910
[  115.456506] fbe0: c1204fc8 d87c4000 00000002 00000000 00000000 00000005 d772fc4c d772fc08
[  115.467298] fc00: c0820848 c0820690 c03f3f6c d6da2c40 80000f80 000000c0 000001fc 8dd7b910
[  115.478086] fc20: d772fc54 d6da2c40 d8209a00 d87c7c00 d772fc92 00000000 ffffb34a d777a900
[  115.488874] fc40: d772fc8c d772fc50 bf1a56a8 c0820780 00000000 00000003 d6da2c40 00000002
[  115.499660] fc60: 00001388 c10a8b10 c0a95480 c1204fc8 00000000 d772e000 00000001 c1203d00
[  115.510434] fc80: d772fcac d772fc90 bf1a57ec bf1a560c 00000000 8dd7b910 d772fcbc d87c7c00
[  115.521198] fca0: d772fcd4 d772fcb0 bf171200 bf1a57c8 d82fe100 d81e0600 d87c7c00 d82fe158
[  115.531943] fcc0: 00000000 00000000 d772fcfc d772fcd8 bf16f414 bf171184 00000000 d81e0600
[  115.542675] fce0: c1204fc8 0000000a d81e0674 00000000 d772fd3c d772fd00 c074fe88 bf16f3bc
[  115.553398] fd00: d772fd24 d772fd10 c0a8fea0 c07512cc d772fd3c 8dd7b910 c07512cc c1204fc8
[  115.564113] fd20: d777a900 d81e0600 0000000a d81e0674 d772fd94 d772fd40 c07506a8 c074fd90
[  115.574817] fd40: 00000406 00000000 000018b2 00008a30 7f1c0300 64020415 1a131100 170f1200
[  115.585512] fd60: 00000016 0001c200 0001c200 8dd7b910 d81e0600 c1204fc8 bebfcbfc d6d7d780
[  115.596188] fd80: c074c660 bebfcbfc d772fdec d772fd98 c0750b78 c0750574 00000500 00000005
[  115.606866] fda0: 00000cbd 00008a3b 7f1c0300 01000415 1a131100 c0a8fea0 00000000 d81e0618
[  115.617535] fdc0: d772fde4 8dd7b910 c0a8fea0 d81e0600 d81e0600 bebfcbfc d6d7d780 c074c660
[  115.628193] fde0: d772fe0c d772fdf0 c0750dcc c0750868 d81e0600 bebfcbfc c1204fc8 d6d7d780
[  115.638839] fe00: d772fe34 d772fe10 c074c698 c0750da0 00005403 d81e0600 c1204fc8 d6d7d780
[  115.649469] fe20: c074c660 bebfcbfc d772fedc d772fe38 c074a5b0 c074c66c bebfcbfc 00000001
[  115.660099] fe40: d772fe84 d772fe50 c03d1a3c c0211be4 c03c1a70 04e00000 ffffe000 c1204fc8
[  115.670732] fe60: 75c9f3df 00000040 c13365c0 75c9f3df 00000000 c03c5ffc d772ff24 d772fe88
[  115.681361] fe80: c03c5ffc c021b7f4 75c9ffdf 04e00000 00000000 d772fea0 c020cf60 c020bbc4
[  115.691988] fea0: c1204fc8 00000000 d755a600 8dd7b910 d6c96068 c1204fc8 bebfcbfc d6d7d780
[  115.702620] fec0: 00000004 bebfcbfc 00000004 d84a4778 d772ff6c d772fee0 c0422dcc c074a324
[  115.713259] fee0: 00000000 ffede3b0 deb34ee8 00000000 d755a600 8dd7b910 d772ff24 d772ffb0
[  115.723897] ff00: d6d0bd00 d755a600 b6e76e50 0000020b d6c96068 c0a95c40 d772ff74 d772ff28
[  115.734536] ff20: c0a95c40 c027b438 c020cf60 c020bbc4 c1204fc8 00000000 ffffffff 8dd7b910
[  115.745197] ff40: 00000000 d6d7d780 d6d7d780 00000000 00005403 bebfcbfc 00000004 00000036
[  115.755860] ff60: d772ff94 d772ff70 c042354c c0422d18 bebfcc78 00000001 00076c18 00000036
[  115.766517] ff80: c02011c4 d772e000 d772ffa4 d772ff98 c0423588 c04234ec 00000000 d772ffa8
[  115.777183] ffa0: c0201000 c042357c bebfcc78 00000001 00000004 00005403 bebfcbfc 00008a30
[  115.787862] ffc0: bebfcc78 00000001 00076c18 00000036 00000004 b6f55bb0 00000001 00000000
[  115.798544] ffe0: 00000000 bebfcbf8 00000000 b6dfb7a4 80000010 00000004 00000000 00000000
[  115.809196] Backtrace:
[  115.814099] [<c08360dc>] (xhci_urb_dequeue) from [<c081cf3c>] (unlink1+0x3c/0x11c)
[  115.824151]  r10:d6da20c0 r9:00001388 r8:d772fc18 r7:fffffffe r6:efb90000 r5:60000013
[  115.834466]  r4:d75316c0
[  115.839475] [<c081cf00>] (unlink1) from [<c081e930>] (usb_hcd_unlink_urb+0x78/0x94)
[  115.849631]  r9:00001388 r8:d772fc18 r7:fffffffe r6:d87c4000 r5:60000013 r4:d75316c0
[  115.859876] [<c081e8b8>] (usb_hcd_unlink_urb) from [<c0820078>] (usb_kill_urb+0x78/0x108)
[  115.870568]  r7:d772fbc8 r6:d75316d0 r5:c1204fc8 r4:d75316c0
[  115.878761] [<c0820000>] (usb_kill_urb) from [<c0820760>] (usb_start_wait_urb+0xdc/0xf0)
[  115.889379]  r7:d772fbc8 r6:00000000 r5:c1204fc8 r4:d75316c0
[  115.897503] [<c0820684>] (usb_start_wait_urb) from [<c0820848>] (usb_control_msg+0xd4/0x12c)
[  115.908359]  r9:00000005 r8:00000000 r7:00000000 r6:00000002 r5:d87c4000 r4:c1204fc8
[  115.918478] [<c0820774>] (usb_control_msg) from [<bf1a56a8>] (ftdi_get_modem_status+0xa8/0x128 [ftdi_sio])
[  115.930497]  r10:d777a900 r9:ffffb34a r8:00000000 r7:d772fc92 r6:d87c7c00 r5:d8209a00
[  115.940667]  r4:d6da2c40
[  115.945531] [<bf1a5600>] (ftdi_get_modem_status [ftdi_sio]) from [<bf1a57ec>] (ftdi_tx_empty+0x30/0x5c [ftdi_sio])
[  115.958280]  r8:c1203d00 r7:00000001 r6:d772e000 r5:00000000 r4:c1204fc8
[  115.967394] [<bf1a57bc>] (ftdi_tx_empty [ftdi_sio]) from [<bf171200>] (usb_serial_generic_wait_until_sent+0x88/0xc8 [usbserial])
[  115.981391]  r4:d87c7c00
[  115.986343] [<bf171178>] (usb_serial_generic_wait_until_sent [usbserial]) from [<bf16f414>] (serial_wait_until_sent+0x64/0x70 [usbserial])
[  116.001255]  r9:00000000 r8:00000000 r7:d82fe158 r6:d87c7c00 r5:d81e0600 r4:d82fe100
[  116.011503] [<bf16f3b0>] (serial_wait_until_sent [usbserial]) from [<c074fe88>] (tty_wait_until_sent+0x104/0x188)
[  116.024295]  r9:00000000 r8:d81e0674 r7:0000000a r6:c1204fc8 r5:d81e0600 r4:00000000
[  116.034575] [<c074fd84>] (tty_wait_until_sent) from [<c07506a8>] (set_termios+0x140/0x2f4)
[  116.045379]  r8:d81e0674 r7:0000000a r6:d81e0600 r5:d777a900 r4:c1204fc8
[  116.054618] [<c0750568>] (set_termios) from [<c0750b78>] (tty_mode_ioctl+0x31c/0x538)
[  116.064999]  r9:bebfcbfc r8:c074c660 r7:d6d7d780 r6:bebfcbfc r5:c1204fc8 r4:d81e0600
[  116.075304] [<c075085c>] (tty_mode_ioctl) from [<c0750dcc>] (n_tty_ioctl_helper+0x38/0x138)
[  116.086227]  r8:c074c660 r7:d6d7d780 r6:bebfcbfc r5:d81e0600 r4:d81e0600
[  116.095499] [<c0750d94>] (n_tty_ioctl_helper) from [<c074c698>] (n_tty_ioctl+0x38/0x13c)
[  116.106170]  r7:d6d7d780 r6:c1204fc8 r5:bebfcbfc r4:d81e0600
[  116.114401] [<c074c660>] (n_tty_ioctl) from [<c074a5b0>] (tty_ioctl+0x298/0x9f4)
[  116.124377]  r9:bebfcbfc r8:c074c660 r7:d6d7d780 r6:c1204fc8 r5:d81e0600 r4:00005403
[  116.134711] [<c074a318>] (tty_ioctl) from [<c0422dcc>] (do_vfs_ioctl+0xc0/0x7d4)
[  116.144684]  r10:d84a4778 r9:00000004 r8:bebfcbfc r7:00000004 r6:d6d7d780 r5:bebfcbfc
[  116.155090]  r4:c1204fc8
[  116.160176] [<c0422d0c>] (do_vfs_ioctl) from [<c042354c>] (ksys_ioctl+0x6c/0x90)
[  116.170140]  r10:00000036 r9:00000004 r8:bebfcbfc r7:00005403 r6:00000000 r5:d6d7d780
[  116.180534]  r4:d6d7d780
[  116.185605] [<c04234e0>] (ksys_ioctl) from [<c0423588>] (sys_ioctl+0x18/0x1c)
[  116.195297]  r9:d772e000 r8:c02011c4 r7:00000036 r6:00076c18 r5:00000001 r4:bebfcc78
[  116.205607] [<c0423570>] (sys_ioctl) from [<c0201000>] (ret_fast_syscall+0x0/0x28)
[  116.215739] Exception stack(0xd772ffa8 to 0xd772fff0)
[  116.223354] ffa0:                   bebfcc78 00000001 00000004 00005403 bebfcbfc 00008a30
[  116.234111] ffc0: bebfcc78 00000001 00076c18 00000036 00000004 b6f55bb0 00000001 00000000
[  116.244862] ffe0: 00000000 bebfcbf8 00000000 b6dfb7a4
[  116.252480] Code: e5933004 f57ff04f e3730001 0a00002a (e597c678)
[  116.261144] ---[ end trace e5ed96736c0aa23c ]---
[  116.277705] raspberrypi-firmware soc:firmware: Request 0x00030046 returned status 0x80000001
[  137.295291] rcu: INFO: rcu_sched detected stalls on CPUs/tasks:
[  137.302984] rcu:     1-...0: (1 GPs behind) idle=cb6/1/0x40000000 softirq=7420/7433 fqs=714
[  137.312899]  (detected by 0, t=2103 jiffies, g=3593, q=2184)
[  137.320295] Sending NMI from CPU 0 to CPUs 1:
[  147.327309] rcu: rcu_sched kthread starved for 1000 jiffies! g3593 f0x0 RCU_GP_DOING_FQS(6) ->state=0x0 ->cpu=2
[  147.339214] rcu: RCU grace-period kthread stack dump:
[  147.346013] rcu_sched       R  running task        0    10      2 0x00000000
[  147.354809] Backtrace:
[  147.358987] [<c0a8f248>] (__schedule) from [<c0a8fe54>] (preempt_schedule_common+0x1c/0x34)
[  147.369088]  r10:c1203d00 r9:ef910000 r8:00000000 r7:c120508c r6:00000000 r5:00000000
[  147.378674]  r4:ffffe000
[  147.382948] [<c0a8fe38>] (preempt_schedule_common) from [<c0a8febc>] (_cond_resched+0x50/0x58)
[  147.393321]  r5:00000000 r4:00000001
[  147.398650] [<c0a8fe6c>] (_cond_resched) from [<c0296718>] (rcu_gp_kthread+0x548/0xa40)
[  147.408420]  r5:00000000 r4:c12110c0
[  147.413752] [<c02961d0>] (rcu_gp_kthread) from [<c0245fd0>] (kthread+0x170/0x174)
[  147.422999]  r7:ef910000
[  147.427282] [<c0245e60>] (kthread) from [<c02010ac>] (ret_from_fork+0x14/0x28)
[  147.436271] Exception stack(0xef911fb0 to 0xef911ff8)
[  147.443086] 1fa0:                                     00000000 00000000 00000000 00000000
[  147.453040] 1fc0: 00000000 00000000 00000000 00000000 00000000 00000000 00000000 00000000
[  147.462983] 1fe0: 00000000 00000000 00000000 00000000 00000013 00000000
[  147.471352]  r10:00000000 r9:00000000 r8:00000000 r7:00000000 r6:00000000 r5:c0245e60
[  147.480932]  r4:ef86fcc0
[  156.945148] ------------[ cut here ]------------
[  156.951535] WARNING: CPU: 3 PID: 24 at net/sched/sch_generic.c:448 dev_watchdog+0x314/0x318
[  156.961652] NETDEV WATCHDOG: eth0 (bcmgenet): transmit queue 0 timed out
[  156.970115] Modules linked in: sha256_generic libsha256 cfg80211 rfkill 8021q garp stp llc ftdi_sio usbserial vc4 cec rpivid_mem v3d drm_kms_helper gpu_sched drm bcm2835_codec(C) bcm2835_v4l2(C) bcm2835_isp(C) v4l2_mem2mem bcm2835_mmal_vchiq(C) videobuf2_dma_contig videobuf2_vmalloc videobuf2_memops videobuf2_v4l2 videobuf2_common drm_panel_orientation_quirks raspberrypi_hwmon snd_soc_core videodev mc vc_sm_cma(C) snd_compress snd_pcm_dmaengine snd_pcm snd_timer snd syscopyarea sysfillrect sysimgblt fb_sys_fops uio_pdrv_genirq uio ip_tables x_tables ipv6
[  157.024882] CPU: 3 PID: 24 Comm: migration/3 Tainted: G      D WC        5.4.79-v7l+ #1373
[  157.035028] Hardware name: BCM2711
[  157.040290] Backtrace:
[  157.044593] [<c020dfb0>] (dump_backtrace) from [<c020e334>] (show_stack+0x20/0x24)
[  157.054024]  r7:ffffffff r6:00000000 r5:60000113 r4:c129fab0
[  157.061536] [<c020e314>] (show_stack) from [<c0a76254>] (dump_stack+0xd8/0x11c)
[  157.070704] [<c0a7617c>] (dump_stack) from [<c0222028>] (__warn+0xe0/0x108)
[  157.079504]  r10:c12a6f78 r9:00000009 r8:c0982fa0 r7:000001c0 r6:00000009 r5:c0982fa0
[  157.089182]  r4:c0e47714 r3:00000000
[  157.094581] [<c0221f48>] (__warn) from [<c0222424>] (warn_slowpath_fmt+0xa4/0xc0)
[  157.103897]  r7:000001c0 r6:c0e47714 r5:c1204fc8 r4:c0e476d8
[  157.111377] [<c0222384>] (warn_slowpath_fmt) from [<c0982fa0>] (dev_watchdog+0x314/0x318)
[  157.121378]  r9:eff48440 r8:ef254000 r7:c1203d00 r6:ef1aa800 r5:ef2542a8 r4:00000000
[  157.130928] [<c0982c8c>] (dev_watchdog) from [<c02a1d94>] (call_timer_fn+0x40/0x1b0)
[  157.140469]  r8:00000000 r7:ffffc820 r6:c0982c8c r5:00000101 r4:ef2542a8
[  157.148947] [<c02a1d54>] (call_timer_fn) from [<c02a25f8>] (run_timer_softirq+0x46c/0x640)
[  157.158974]  r8:00000000 r7:ffffc820 r6:00000000 r5:ef93fd34 r4:ef2542a8
[  157.167434] [<c02a218c>] (run_timer_softirq) from [<c0202484>] (__do_softirq+0x194/0x444)
[  157.177377]  r10:ffffe000 r9:ef93e000 r8:00000002 r7:00000101 r6:00000001 r5:00000002
[  157.186960]  r4:c1203084
[  157.191236] [<c02022f0>] (__do_softirq) from [<c02282f4>] (irq_exit+0xdc/0x100)
[  157.200292]  r10:00000000 r9:ef93e000 r8:ef850800 r7:00000001 r6:00000000 r5:00000000
[  157.209875]  r4:ffffe000
[  157.214149] [<c0228218>] (irq_exit) from [<c0284668>] (__handle_domain_irq+0x70/0xc4)
[  157.223725]  r5:00000000 r4:c10aa2a4
[  157.229044] [<c02845f8>] (__handle_domain_irq) from [<c02022b4>] (gic_handle_irq+0x4c/0x88)
[  157.239151]  r9:ef93e000 r8:f0815000 r7:ef93fe60 r6:f0814000 r5:f081400c r4:c1205a34
[  157.248654] [<c0202268>] (gic_handle_irq) from [<c0201a3c>] (__irq_svc+0x5c/0x7c)
[  157.257884] Exception stack(0xef93fe60 to 0xef93fea8)
[  157.264684] fe60: c1204ff0 00000000 00000002 00000000 ef939e00 00000001 00000001 00000000
[  157.274622] fe80: c1204ff0 ef939dec 00000000 ef93febc ef93fec0 ef93feb0 c02dd3b8 c02dd338
[  157.284549] fea0: 60000013 ffffffff
[  157.289772]  r9:ef93e000 r8:c1204ff0 r7:ef93fe94 r6:ffffffff r5:60000013 r4:c02dd338
[  157.299267] [<c02dd32c>] (stop_machine_yield) from [<c02dd3b8>] (multi_cpu_stop+0x74/0x178)
[  157.309363] [<c02dd344>] (multi_cpu_stop) from [<c02dd124>] (cpu_stopper_thread+0x90/0x164)
[  157.319463]  r10:ef939d8c r9:eff49988 r8:eff49990 r7:ef939dec r6:c02dd344 r5:ffffe000
[  157.329050]  r4:eff49984
[  157.333316] [<c02dd094>] (cpu_stopper_thread) from [<c0249de4>] (smpboot_thread_fn+0x110/0x1e8)
[  157.343771]  r10:00000000 r9:00000000 r8:00000001 r7:c1204fc8 r6:c1217204 r5:ffffe000
[  157.353364]  r4:ef87f740
[  157.357651] [<c0249cd4>] (smpboot_thread_fn) from [<c0245fd0>] (kthread+0x170/0x174)
[  157.367147]  r10:ef8dbda4 r9:c0249cd4 r8:ef87f740 r7:ef93e000 r6:00000000 r5:ef87f7c0
[  157.376746]  r4:ef87f800
[  157.381032] [<c0245e60>] (kthread) from [<c02010ac>] (ret_from_fork+0x14/0x28)
[  157.390020] Exception stack(0xef93ffb0 to 0xef93fff8)
[  157.396821] ffa0:                                     00000000 00000000 00000000 00000000
[  157.406762] ffc0: 00000000 00000000 00000000 00000000 00000000 00000000 00000000 00000000
[  157.416699] ffe0: 00000000 00000000 00000000 00000000 00000013 00000000
[  157.425064]  r10:00000000 r9:00000000 r8:00000000 r7:00000000 r6:00000000 r5:c0245e60
[  157.434624]  r4:ef87f7c0
[  157.438875] ---[ end trace e5ed96736c0aa23d ]---
[  200.345089] rcu: INFO: rcu_sched detected stalls on CPUs/tasks:
[  200.352737] rcu:     1-...0: (1 GPs behind) idle=cb6/1/0x40000000 softirq=7420/7433 fqs=715
[  200.362638]  (detected by 0, t=8408 jiffies, g=3593, q=2187)
[  200.370014] Sending NMI from CPU 0 to CPUs 1:
[  210.377010] rcu: rcu_sched kthread starved for 7305 jiffies! g3593 f0x2 RCU_GP_DOING_FQS(6) ->state=0x0 ->cpu=0
[  210.388827] rcu: RCU grace-period kthread stack dump:
[  210.395593] rcu_sched       R  running task        0    10      2 0x00000000
[  210.404357] Backtrace:
[  210.408514] [<c0a8f248>] (__schedule) from [<c0a8fe54>] (preempt_schedule_common+0x1c/0x34)
[  210.418579]  r10:c1203d00 r9:ef910000 r8:00000000 r7:c120508c r6:00000000 r5:00000000
[  210.428128]  r4:ffffe000
[  210.432366] [<c0a8fe38>] (preempt_schedule_common) from [<c0a8febc>] (_cond_resched+0x50/0x58)
[  210.442707]  r5:00000000 r4:00000001
[  210.448000] [<c0a8fe6c>] (_cond_resched) from [<c0296718>] (rcu_gp_kthread+0x548/0xa40)
[  210.457742]  r5:00000000 r4:c12110c0
[  210.463051] [<c02961d0>] (rcu_gp_kthread) from [<c0245fd0>] (kthread+0x170/0x174)
[  210.472291]  r7:ef910000
[  210.476563] [<c0245e60>] (kthread) from [<c02010ac>] (ret_from_fork+0x14/0x28)
[  210.485531] Exception stack(0xef911fb0 to 0xef911ff8)
[  210.492331] 1fa0:                                     00000000 00000000 00000000 00000000
[  210.502255] 1fc0: 00000000 00000000 00000000 00000000 00000000 00000000 00000000 00000000
[  210.512144] 1fe0: 00000000 00000000 00000000 00000000 00000013 00000000
[  210.520410]  r10:00000000 r9:00000000 r8:00000000 r7:00000000 r6:00000000 r5:c0245e60
[  210.529849]  r4:ef86fcc0
[  263.395085] rcu: INFO: rcu_sched detected stalls on CPUs/tasks:
[  263.402601] rcu:     1-...0: (1 GPs behind) idle=cb6/1/0x40000000 softirq=7420/7433 fqs=715
[  263.412387]  (detected by 0, t=14713 jiffies, g=3593, q=2187)
[  263.419739] Sending NMI from CPU 0 to CPUs 1:
[  273.426617] rcu: rcu_sched kthread starved for 13610 jiffies! g3593 f0x2 RCU_GP_DOING_FQS(6) ->state=0x0 ->cpu=0
[  273.438413] rcu: RCU grace-period kthread stack dump:
[  273.445088] rcu_sched       R  running task        0    10      2 0x00000000
[  273.453755] Backtrace:
[  273.457812] [<c0a8f248>] (__schedule) from [<c0a8fe54>] (preempt_schedule_common+0x1c/0x34)
[  273.467789]  r10:c1203d00 r9:ef910000 r8:00000000 r7:c120508c r6:00000000 r5:00000000
[  273.477251]  r4:ffffe000
[  273.481396] [<c0a8fe38>] (preempt_schedule_common) from [<c0a8febc>] (_cond_resched+0x50/0x58)
[  273.491646]  r5:00000000 r4:00000001
[  273.496841] [<c0a8fe6c>] (_cond_resched) from [<c0296718>] (rcu_gp_kthread+0x548/0xa40)
[  273.506480]  r5:00000000 r4:c12110c0
[  273.511672] [<c02961d0>] (rcu_gp_kthread) from [<c0245fd0>] (kthread+0x170/0x174)
[  273.520777]  r7:ef910000
[  273.524921] [<c0245e60>] (kthread) from [<c02010ac>] (ret_from_fork+0x14/0x28)
[  273.533763] Exception stack(0xef911fb0 to 0xef911ff8)
[  273.540424] 1fa0:                                     00000000 00000000 00000000 00000000
[  273.550232] 1fc0: 00000000 00000000 00000000 00000000 00000000 00000000 00000000 00000000
[  273.560026] 1fe0: 00000000 00000000 00000000 00000000 00000013 00000000
[  273.568242]  r10:00000000 r9:00000000 r8:00000000 r7:00000000 r6:00000000 r5:c0245e60
[
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

Thread 49 (2021-04-28):

Mention Commercial Options

lathama, 2021-04-28:
I was about to build one and found a commercial option from Coolgear Inc. with model number USB-32COM-RM that I have on order. It may be an option for those that do not want to build as the costs are close to the BOM

stapelberg, 2021-04-28:
Thanks for the pointer!

Searching for the model number without the vendor yields a similar device at https://www.vscom.de/vscom-usb-32com-rm.html, which is phased out however. Not sure how long the Coolgear one has been around/will be around :)

I’m curious what you think about the Coolgear device once you have it.

I originally bought a commercial one second-hand, too, but was disappointed with hardware reliability (device wouldn’t work well) and software quality (terribly old stack, unmaintained).

lathama, 2021-04-29:
I will report back after some testing. Has not arrived yet, trying to think about how to load test it.

lathama, 2021-05-05:
Arrived, here is what it looks like from lsusb
```
Bus 003 Device 018: ID 0403:6011 Future Technology Devices International, Ltd FT4232H Quad HS USB-UART/FIFO IC
Bus 003 Device 017: ID 0403:6011 Future Technology Devices International, Ltd FT4232H Quad HS USB-UART/FIFO IC
Bus 003 Device 015: ID 0403:6011 Future Technology Devices International, Ltd FT4232H Quad HS USB-UART/FIFO IC
Bus 003 Device 013: ID 0403:6011 Future Technology Devices International, Ltd FT4232H Quad HS USB-UART/FIFO IC
Bus 003 Device 016: ID 0403:6011 Future Technology Devices International, Ltd FT4232H Quad HS USB-UART/FIFO IC
Bus 003 Device 014: ID 0403:6011 Future Technology Devices International, Ltd FT4232H Quad HS USB-UART/FIFO IC
Bus 003 Device 012: ID 0403:6011 Future Technology Devices International, Ltd FT4232H Quad HS USB-UART/FIFO IC
Bus 003 Device 011: ID 0403:6011 Future Technology Devices International, Ltd FT4232H Quad HS USB-UART/FIFO IC
```

lathama, 2021-05-05:
Pictures at https://lathama.net/USB-32COM-RM

lathama, 2021-05-06:
Works well, trying to figure out how the ports got loaded in order because that is awesome.

stapelberg, 2021-05-09:
Can you run lsusb.py (part of the lsusb package on some distributions) as well to show the topology?

Are you planning to use the freetserv Raspberry Pi setup with this device, then?

lathama, 2021-05-09:
`
/:  Bus 01.Port 1: Dev 1, Class=root_hub, Driver=ehci-pci/5p, 480M
    ID 1d6b:0002 Linux Foundation 2.0 root hub
    |__ Port 5: Dev 53, If 0, Class=Hub, Driver=hub/4p, 480M
        ID 05e3:0610 Genesys Logic, Inc. Hub
        |__ Port 1: Dev 54, If 0, Class=Hub, Driver=hub/4p, 480M
            ID 05e3:0610 Genesys Logic, Inc. Hub
            |__ Port 1: Dev 56, If 2, Class=Vendor Specific Class, Driver=ftdi_sio, 480M
                ID 0403:6011 Future Technology Devices International, Ltd FT4232H Quad HS USB-UART/FIFO IC
            |__ Port 1: Dev 56, If 0, Class=Vendor Specific Class, Driver=ftdi_sio, 480M
                ID 0403:6011 Future Technology Devices International, Ltd FT4232H Quad HS USB-UART/FIFO IC
            |__ Port 1: Dev 56, If 3, Class=Vendor Specific Class, Driver=ftdi_sio, 480M
                ID 0403:6011 Future Technology Devices International, Ltd FT4232H Quad HS USB-UART/FIFO IC
            |__ Port 1: Dev 56, If 1, Class=Vendor Specific Class, Driver=ftdi_sio, 480M
                ID 0403:6011 Future Technology Devices International, Ltd FT4232H Quad HS USB-UART/FIFO IC
            |__ Port 2: Dev 58, If 2, Class=Vendor Specific Class, Driver=ftdi_sio, 480M
                ID 0403:6011 Future Technology Devices International, Ltd FT4232H Quad HS USB-UART/FIFO IC
            |__ Port 2: Dev 58, If 0, Class=Vendor Specific Class, Driver=ftdi_sio, 480M
                ID 0403:6011 Future Technology Devices International, Ltd FT4232H Quad HS USB-UART/FIFO IC
            |__ Port 2: Dev 58, If 3, Class=Vendor Specific Class, Driver=ftdi_sio, 480M
                ID 0403:6011 Future Technology Devices International, Ltd FT4232H Quad HS USB-UART/FIFO IC
            |__ Port 2: Dev 58, If 1, Class=Vendor Specific Class, Driver=ftdi_sio, 480M
                ID 0403:6011 Future Technology Devices International, Ltd FT4232H Quad HS USB-UART/FIFO IC
            |__ Port 3: Dev 60, If 3, Class=Vendor Specific Class, Driver=ftdi_sio, 480M
                ID 0403:6011 Future Technology Devices International, Ltd FT4232H Quad HS USB-UART/FIFO IC
            |__ Port 3: Dev 60, If 1, Class=Vendor Specific Class, Driver=ftdi_sio, 480M
                ID 0403:6011 Future Technology Devices International, Ltd FT4232H Quad HS USB-UART/FIFO IC
            |__ Port 3: Dev 60, If 2, Class=Vendor Specific Class, Driver=ftdi_sio, 480M
                ID 0403:6011 Future Technology Devices International, Ltd FT4232H Quad HS USB-UART/FIFO IC
            |__ Port 3: Dev 60, If 0, Class=Vendor Specific Class, Driver=ftdi_sio, 480M
                ID 0403:6011 Future Technology Devices International, Ltd FT4232H Quad HS USB-UART/FIFO IC
            |__ Port 4: Dev 62, If 0, Class=Vendor Specific Class, Driver=ftdi_sio, 480M
                ID 0403:6011 Future Technology Devices International, Ltd FT4232H Quad HS USB-UART/FIFO IC
            |__ Port 4: Dev 62, If 1, Class=Vendor Specific Class, Driver=ftdi_sio, 480M
                ID 0403:6011 Future Technology Devices International, Ltd FT4232H Quad HS USB-UART/FIFO IC
            |__ Port 4: Dev 62, If 2, Class=Vendor Specific Class, Driver=ftdi_sio, 480M
                ID 0403:6011 Future Technology Devices International, Ltd FT4232H Quad HS USB-UART/FIFO IC
            |__ Port 4: Dev 62, If 3, Class=Vendor Specific Class, Driver=ftdi_sio, 480M
                ID 0403:6011 Future Technology Devices International, Ltd FT4232H Quad HS USB-UART/FIFO IC
        |__ Port 2: Dev 55, If 0, Class=Hub, Driver=hub/4p, 480M
            ID 05e3:0610 Genesys Logic, Inc. Hub
            |__ Port 3: Dev 61, If 0, Class=Vendor Specific Class, Driver=ftdi_sio, 480M
                ID 0403:6011 Future Technology Devices International, Ltd FT4232H Quad HS USB-UART/FIFO IC
            |__ Port 3: Dev 61, If 3, Class=Vendor Specific Class, Driver=ftdi_sio, 480M
                ID 0403:6011 Future Technology Devices International, Ltd FT4232H Quad HS USB-UART/FIFO IC
            |__ Port 3: Dev 61, If 1, Class=Vendor Specific Class, Driver=ftdi_sio, 480M
                ID 0403:6011 Future Technology Devices International, Ltd FT4232H Quad HS USB-UART/FIFO IC
            |__ Port 3: Dev 61, If 2, Class=Vendor Specific Class, Driver=ftdi_sio, 480M
                ID 0403:6011 Future Technology Devices International, Ltd FT4232H Quad HS USB-UART/FIFO IC
            |__ Port 1: Dev 57, If 1, Class=Vendor Specific Class, Driver=ftdi_sio, 480M
                ID 0403:6011 Future Technology Devices International, Ltd FT4232H Quad HS USB-UART/FIFO IC
            |__ Port 1: Dev 57, If 2, Class=Vendor Specific Class, Driver=ftdi_sio, 480M
                ID 0403:6011 Future Technology Devices International, Ltd FT4232H Quad HS USB-UART/FIFO IC
            |__ Port 1: Dev 57, If 0, Class=Vendor Specific Class, Driver=ftdi_sio, 480M
                ID 0403:6011 Future Technology Devices International, Ltd FT4232H Quad HS USB-UART/FIFO IC
            |__ Port 1: Dev 57, If 3, Class=Vendor Specific Class, Driver=ftdi_sio, 480M
                ID 0403:6011 Future Technology Devices International, Ltd FT4232H Quad HS USB-UART/FIFO IC
            |__ Port 4: Dev 63, If 2, Class=Vendor Specific Class, Driver=ftdi_sio, 480M
                ID 0403:6011 Future Technology Devices International, Ltd FT4232H Quad HS USB-UART/FIFO IC
            |__ Port 4: Dev 63, If 0, Class=Vendor Specific Class, Driver=ftdi_sio, 480M
                ID 0403:6011 Future Technology Devices International, Ltd FT4232H Quad HS USB-UART/FIFO IC
            |__ Port 4: Dev 63, If 3, Class=Vendor Specific Class, Driver=ftdi_sio, 480M
                ID 0403:6011 Future Technology Devices International, Ltd FT4232H Quad HS USB-UART/FIFO IC
            |__ Port 4: Dev 63, If 1, Class=Vendor Specific Class, Driver=ftdi_sio, 480M
                ID 0403:6011 Future Technology Devices International, Ltd FT4232H Quad HS USB-UART/FIFO IC
            |__ Port 2: Dev 59, If 3, Class=Vendor Specific Class, Driver=ftdi_sio, 480M
                ID 0403:6011 Future Technology Devices International, Ltd FT4232H Quad HS USB-UART/FIFO IC
            |__ Port 2: Dev 59, If 1, Class=Vendor Specific Class, Driver=ftdi_sio, 480M
                ID 0403:6011 Future Technology Devices International, Ltd FT4232H Quad HS USB-UART/FIFO IC
            |__ Port 2: Dev 59, If 2, Class=Vendor Specific Class, Driver=ftdi_sio, 480M
                ID 0403:6011 Future Technology Devices International, Ltd FT4232H Quad HS USB-UART/FIFO IC
            |__ Port 2: Dev 59, If 0, Class=Vendor Specific Class, Driver=ftdi_sio, 480M
                ID 0403:6011 Future Technology Devices International, Ltd FT4232H Quad HS USB-UART/FIFO IC
`

Currently controlled by a PC Engines APU2. When I opened the case I noted there is room to install a SBC inside.

lathama, 2021-05-09:
https://lathama.net/USB-32COM-RM#Software_Setup for the software setup I just did. Turned out to be simpler than I thought

stapelberg, 2021-05-14:
Mentioned this (including links to the product and your notes) on the freetserv github page.

If you think anything else should be mentioned/changed, please submit a pull request with your suggestion.

Thank you!

lathama, 2021-05-14:
Thanks, I will keep an eye out for other options and some day get the cycles to build my own

Closed 2021-05-14.
