freetserv/freetserv/freetserv.brd

## EAGLE design freetserv.brd (2016-04-01)

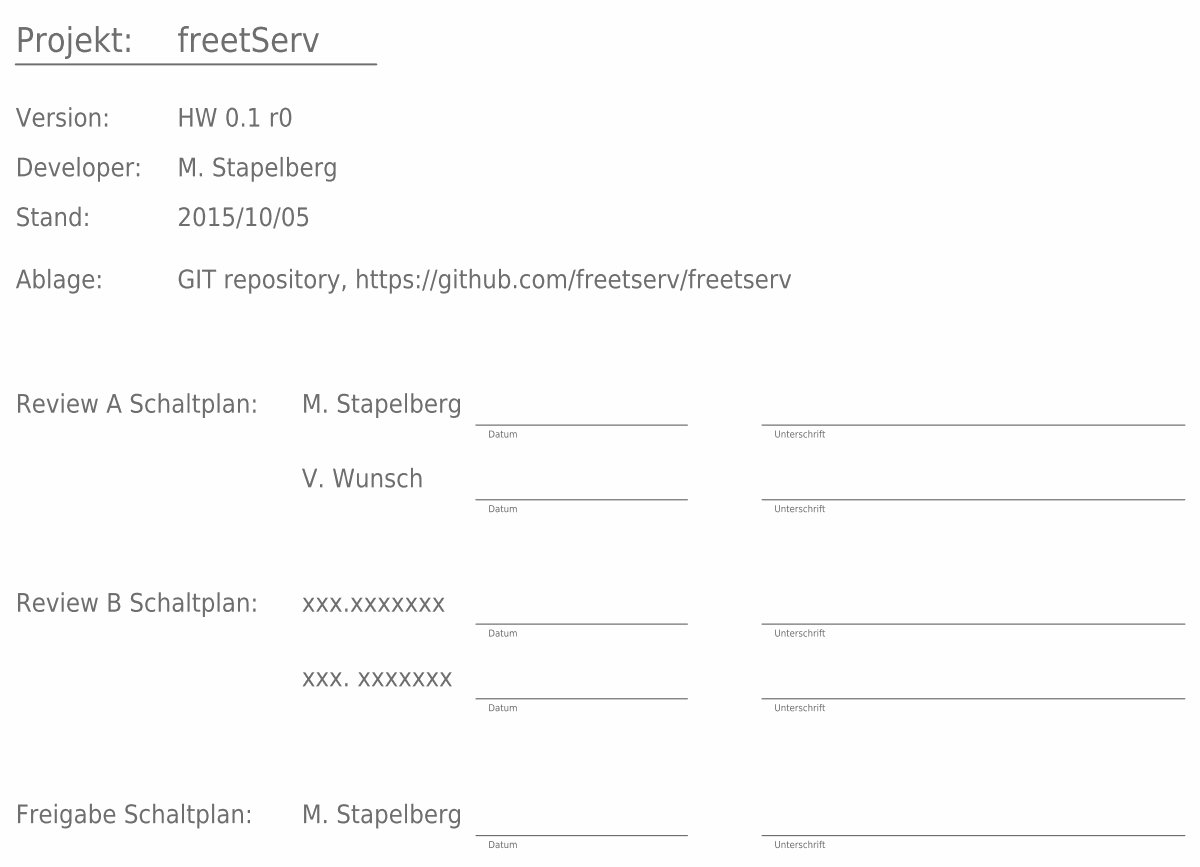
[picture p1: schematic freetserv.sch, sheet 1]

Notes on the sheet:
freetServ
Projekt:
Version:
HW 0.1 r0
Developer:
M. Stapelberg
Stand:
2015/10/05
Review A Schaltplan:
Datum
Unterschrift
V. Wunsch
Freigabe Schaltplan:
Ablage:
GIT repository, https://github.com/freetserv/freetserv
Review B Schaltplan:
xxx.xxxxxxx
xxx. xxxxxxx

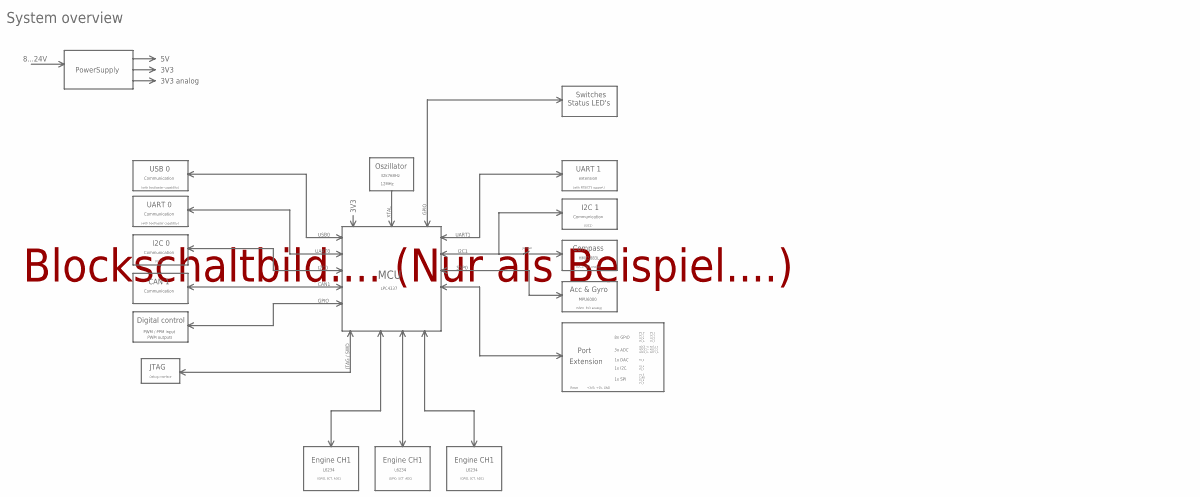
[picture p2: schematic freetserv.sch, sheet 2]

Notes on the sheet:
System overview
MCU
PowerSupply
3V3
3V3 analog
8...24V
JTAG
PWM / PPM input
PWM outputs
Digital control
Communication
CAN 1
I2C 0
UART 0
USB 0
(with bootloader capability)
Debug interface
I2C 1
UART 1
extension
(with RTS/CTS support)
8x GPIO
Port
Extension
3x ADC
1x DAC
1x I2C
1x SPI
Reset
+3V3, +5V, GND
(I2C0)
HMC5883L
Compass
Jumper
I2C1
UART1
UART0
USB0
I2C0
(I2C1)
MPU6000
Acc & Gyro
SSP0
CAN1
(I2C1, 3V3 analog)
(SSP0, 3V3 analog)
P2_4
P2_3
P1_5
CLK0
P1_4
P1_3
ADC0_4 / ADC1_4
ADC0_5 / ADC1_5
ADC0_6 / ADC1_6
P5_0
P5_1
P5_2
P5_3
P5_4
P5_5
P5_6
P5_7
P4_4
Oszillator
32k768Hz
12MHz
Switches
Status LED's
GPIO
XTAL
JTAG / SWD
L6234
Engine CH1
(GPIO, SCT, ADC)
LPC4337
Blockschaltbild.... (Nur als Beispiel....)

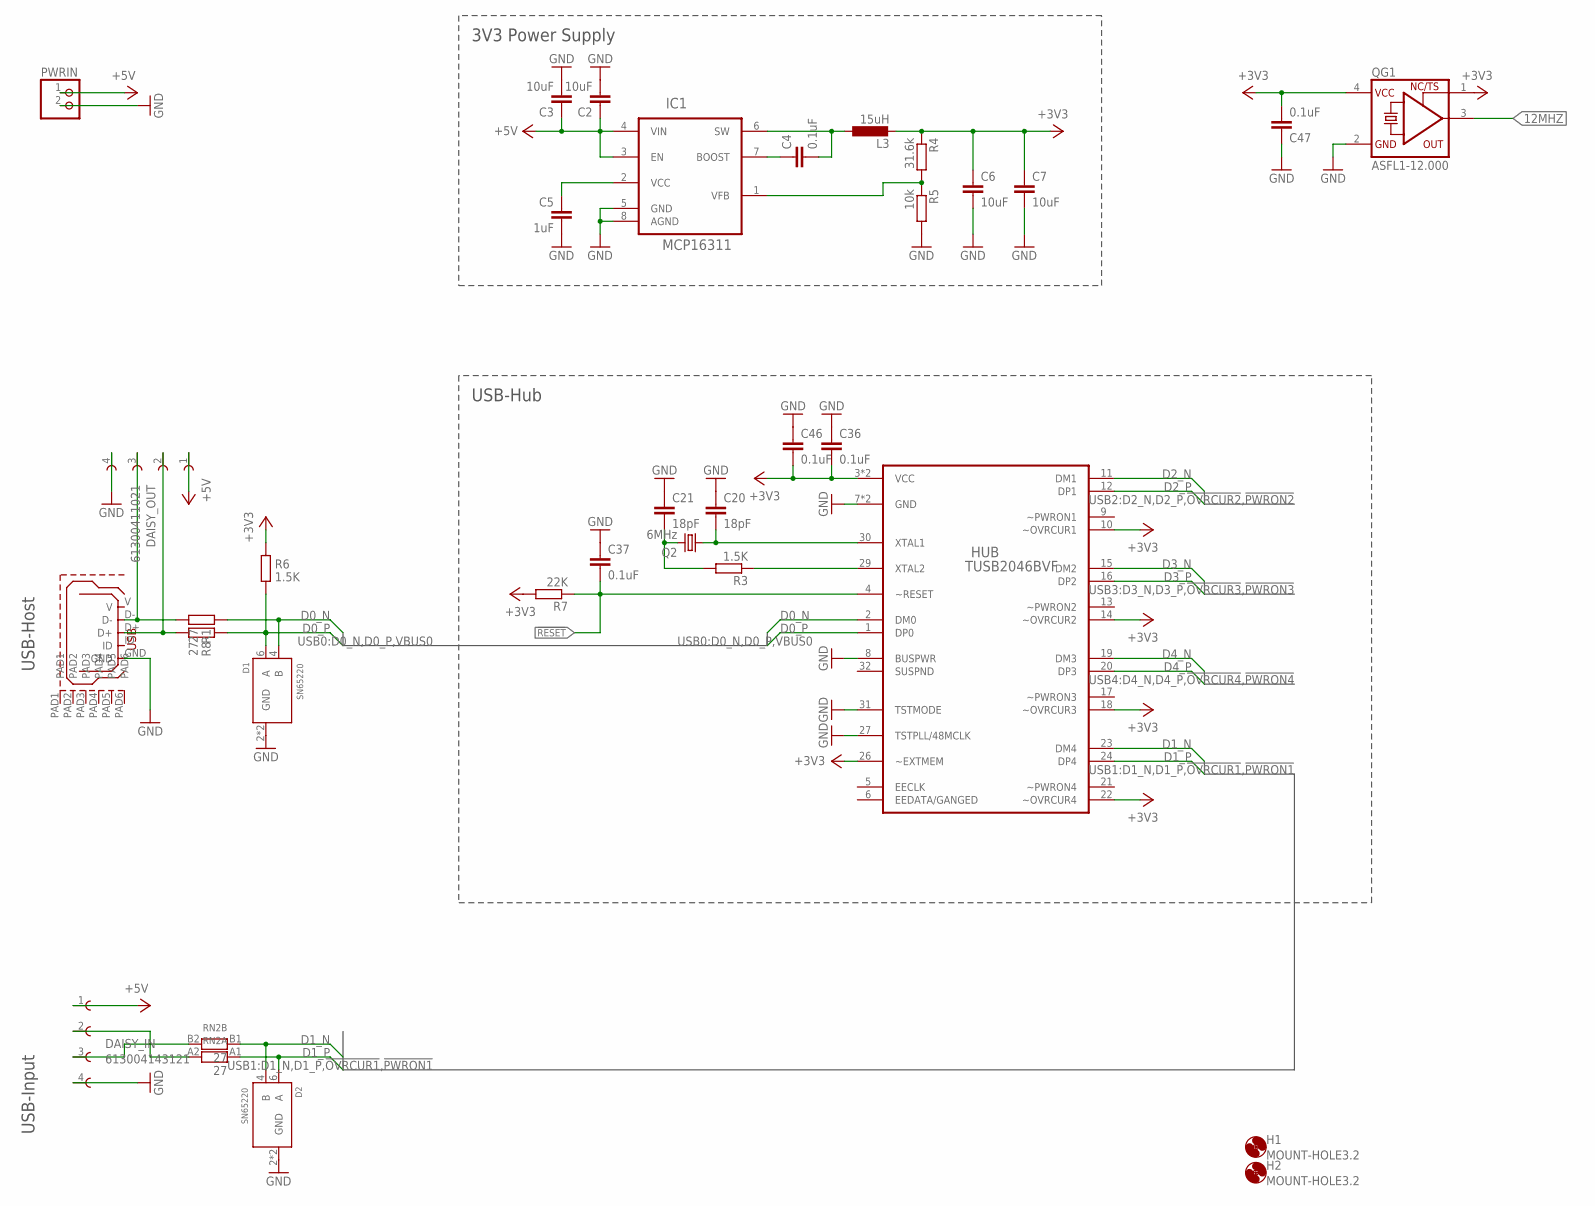
[picture p3: schematic freetserv.sch, sheet 3]

Parts:
C2, C3, C6, C7: 10uF; C0805; PARTNO 490-10517-1-ND
C4, C36, C37, C46, C47: 0.1uF; C0805; PARTNO 1276-1003-1-ND
C5: 1uF; C0805; PARTNO 311-1365-1-ND
C20, C21: 18pF; C0805; PARTNO 709-1171-1-ND
D1, D2: SN65220; SOT23-6; PARTNO 296-9694-1-ND
DAISY_IN: 613004143121; PARTNO 732-2863-ND
DAISY_OUT: 61300411021; PARTNO 732-5337-ND
H1, H2: MOUNT-HOLE3.2; 3,2
HUB: TUSB2046BVF; QFP80P900X900X145-32N
IC1: MCP16311; MSOP8; PARTNO MCP16311-E/MS-ND
L3: 15uH; NR60XX; PARTNO 587-2624-1-ND
PWRIN: PINHD-1X2; 1X02; PARTNO A1921-ND
Q2: 6MHz; CSM-7X-DU; PARTNO 535-10208-1-ND
QG1: ASFL1-12.000; XO53; PARTNO 535-9253-1-ND
R1, R8: 27; R0805; PARTNO 311-27ARCT-ND
R3, R6: 1.5K; R0805; PARTNO 311-1.5KARCT-ND
R4: 31.6k; R0805; PARTNO 311-31.6KCRCT-ND
R5: 10k; R0805; PARTNO 311-10KARCT-ND
R7: 22K; R0805; PARTNO 311-22KARCT-ND
RN2: 27; EXBV4V; PARTNO Y2270CT-ND
USB_HOST: USB_MICROB; USB_MICROB_PACKAGE; PARTNO H11634CT-ND

Connections:
12MHZ: QG1.3 (OUT); also elsewhere on the board
!RESET: C37.2, HUB.4 (~RESET), R7.1; also elsewhere on the board
+3V3: C6.1, C7.1, C36.2, C46.2, C47.2, HUB.3 (VCC), HUB.10 (~OVRCUR1), HUB.14 (~OVRCUR2), HUB.18 (~OVRCUR3), HUB.22 (~OVRCUR4), HUB.25 (VCC), HUB.26 (~EXTMEM), L3.2, QG1.1 (TS), QG1.4 (VCC), R4.1, R6.1, R7.2; also elsewhere on the board
+5V: C2.1, C3.1, DAISY_IN.1, DAISY_OUT.1, IC1.3 (EN), IC1.4 (VIN), PWRIN.1
D0_N: D1.4 (B), HUB.2 (DM0), R1.1
D0_P: D1.6 (A), HUB.1 (DP0), R6.2, R8.1
D1_N: D2.4 (B), HUB.23 (DM4), RN2.B1 (1)
D1_P: D2.6 (A), HUB.24 (DP4), RN2.A1 (1)
D2_N: HUB.11 (DM1); also elsewhere on the board
D2_P: HUB.12 (DP1); also elsewhere on the board
D3_N: HUB.15 (DM2); also elsewhere on the board
D3_P: HUB.16 (DP2); also elsewhere on the board
D4_N: HUB.19 (DM3); also elsewhere on the board
D4_P: HUB.20 (DP3); also elsewhere on the board
DX0_N: DAISY_OUT.3, R1.2, USB_HOST.D-
DX0_P: DAISY_OUT.2, R8.2, USB_HOST.D+
GND: C2.2, C3.2, C5.2, C6.2, C7.2, C20.1, C21.1, C36.1, C37.1, C46.1, C47.1, D1.2 (GND), D1.5 (GND), D2.2 (GND), D2.5 (GND), DAISY_IN.4, DAISY_OUT.4, HUB.7 (GND), HUB.8 (BUSPWR), HUB.27 (TSTPLL/48MCLK), HUB.28 (GND), HUB.31 (TSTMODE), IC1.5 (GND), IC1.8 (AGND), PWRIN.2, QG1.2 (GND), R5.2, USB_HOST.GND; also elsewhere on the board
unnamed: C4.1, IC1.7 (BOOST)
unnamed: C4.2, IC1.6 (SW), L3.1
unnamed: IC1.1 (VFB), R4.2, R5.1
unnamed: DAISY_IN.2, RN2.A2 (2)
unnamed: DAISY_IN.3, RN2.B2 (2)
unnamed: C5.1, IC1.2 (VCC)
unnamed: HUB.29 (XTAL2), R3.1
unnamed: C20.2, HUB.30 (XTAL1), Q2.1
unnamed: C21.2, Q2.2, R3.2

Notes on the sheet:
3V3 Power Supply
USB-Hub
USB-Input
USB-Host

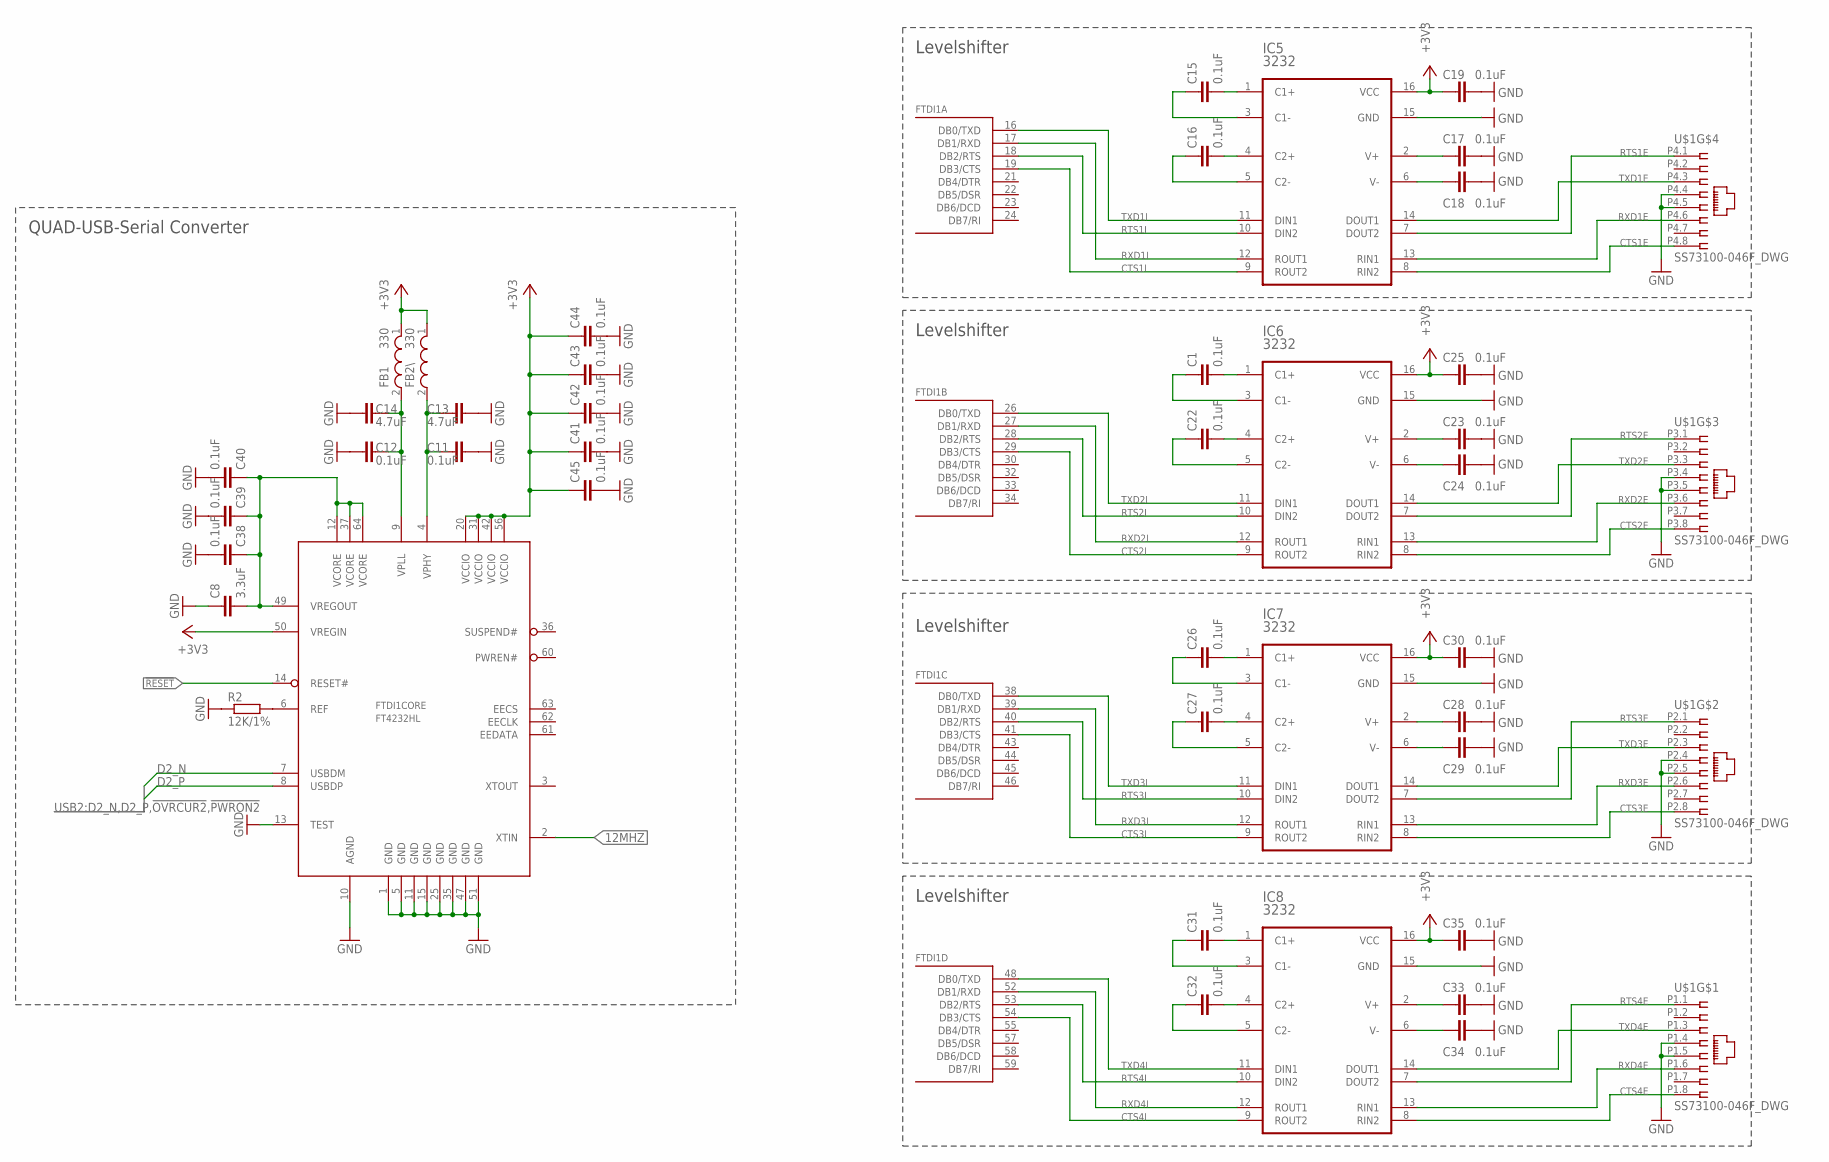
[picture p4: schematic freetserv.sch, sheet 4]

Parts:
C1, C11, C12, C15, C16, C17, C18, C19, C22, C23, C24, C25, C26, C27, C28, C29, C30, C31, C32, C33, C34, C35, C38, C39, C40, C41, C42, C43, C44, C45: 0.1uF; C0805; PARTNO 1276-1003-1-ND
C8: 3.3uF; C0805; PARTNO 445-7589-1-ND
C13, C14: 4.7uF; C0805; PARTNO 1276-2972-1-ND
FB1, FB2\: 330; WE-KI_0805A; PARTNO 490-5988-1-ND
FTDI1: FT4232HL; LQFP64; PARTNO 768-1026-1-ND
IC5, IC6, IC7, IC8: 3232; SOP65P640X120-16N; PARTNO 296-19263-1-ND
R2: 12K/1%; R0805; PARTNO 311-12.0KCRCT-ND
U$1: SS73100-046F_DWG; SS73100-046F; PARTNO 380-1225-ND

Connections:
12MHZ: FTDI1.2 (XTIN); also elsewhere on the board
!RESET: FTDI1.14 (RESET#); also elsewhere on the board
+1V8-1: C8.2, C38.1, C39.1, C40.1, FTDI1.12 (VCORE), FTDI1.37 (VCORE), FTDI1.49 (VREGOUT), FTDI1.64 (VCORE)
+3V3: C19.2, C25.2, C30.2, C35.2, C41.1, C42.1, C43.1, C44.1, C45.1, FB1.1, FB2\.1, FTDI1.20 (VCCIO), FTDI1.31 (VCCIO), FTDI1.42 (VCCIO), FTDI1.50 (VREGIN), FTDI1.56 (VCCIO), IC5.16 (VCC), IC6.16 (VCC), IC7.16 (VCC), IC8.16 (VCC); also elsewhere on the board
CTS1E: IC5.8 (RIN2), U$1.P4.8 (8)
CTS1I: FTDI1.19 (DB3/CTS), IC5.9 (ROUT2)
CTS2E: IC6.8 (RIN2), U$1.P3.8 (8)
CTS2I: FTDI1.29 (DB3/CTS), IC6.9 (ROUT2)
CTS3E: IC7.8 (RIN2), U$1.P2.8 (8)
CTS3I: FTDI1.41 (DB3/CTS), IC7.9 (ROUT2)
CTS4E: IC8.8 (RIN2), U$1.P1.8 (8)
CTS4I: FTDI1.54 (DB3/CTS), IC8.9 (ROUT2)
D2_N: FTDI1.7 (USBDM); also elsewhere on the board
D2_P: FTDI1.8 (USBDP); also elsewhere on the board
GND: C8.1, C11.2, C12.2, C13.2, C14.2, C17.1, C18.1, C19.1, C23.1, C24.1, C25.1, C28.1, C29.1, C30.1, C33.1, C34.1, C35.1, C38.2, C39.2, C40.2, C41.2, C42.2, C43.2, C44.2, C45.2, FTDI1.1 (GND), FTDI1.5 (GND), FTDI1.10 (AGND), FTDI1.11 (GND), FTDI1.13 (TEST), FTDI1.15 (GND), FTDI1.25 (GND), FTDI1.35 (GND), FTDI1.47 (GND), FTDI1.51 (GND), IC5.15 (GND), IC6.15 (GND), IC7.15 (GND), IC8.15 (GND), R2.1, U$1.P1.4 (4), U$1.P1.5 (5), U$1.P2.4 (4), U$1.P2.5 (5), U$1.P3.4 (4), U$1.P3.5 (5), U$1.P4.4 (4), U$1.P4.5 (5); also elsewhere on the board
unnamed: C1.2, IC6.1 (C1+)
unnamed: C1.1, IC6.3 (C1-)
unnamed: C22.2, IC6.4 (C2+)
unnamed: C22.1, IC6.5 (C2-)
unnamed: FTDI1.6 (REF), R2.2
unnamed: C11.1, C13.1, FB2\.2, FTDI1.4 (VPHY)
unnamed: C12.1, C14.1, FB1.2, FTDI1.9 (VPLL)
unnamed: C23.2, IC6.2 (V+)
unnamed: C24.2, IC6.6 (V-)
unnamed: C15.2, IC5.1 (C1+)
unnamed: C15.1, IC5.3 (C1-)
unnamed: C16.2, IC5.4 (C2+)
unnamed: C16.1, IC5.5 (C2-)
unnamed: C17.2, IC5.2 (V+)
unnamed: C18.2, IC5.6 (V-)
unnamed: C26.2, IC7.1 (C1+)
unnamed: C26.1, IC7.3 (C1-)
unnamed: C27.2, IC7.4 (C2+)
unnamed: C27.1, IC7.5 (C2-)
unnamed: C28.2, IC7.2 (V+)
unnamed: C29.2, IC7.6 (V-)
unnamed: C31.2, IC8.1 (C1+)
unnamed: C31.1, IC8.3 (C1-)
unnamed: C32.2, IC8.4 (C2+)
unnamed: C32.1, IC8.5 (C2-)
unnamed: C33.2, IC8.2 (V+)
unnamed: C34.2, IC8.6 (V-)
RTS1E: IC5.7 (DOUT2), U$1.P4.1 (1)
RTS1I: FTDI1.18 (DB2/RTS), IC5.10 (DIN2)
RTS2E: IC6.7 (DOUT2), U$1.P3.1 (1)
RTS2I: FTDI1.28 (DB2/RTS), IC6.10 (DIN2)
RTS3E: IC7.7 (DOUT2), U$1.P2.1 (1)
RTS3I: FTDI1.40 (DB2/RTS), IC7.10 (DIN2)
RTS4E: IC8.7 (DOUT2), U$1.P1.1 (1)
RTS4I: FTDI1.53 (DB2/RTS), IC8.10 (DIN2)
RXD1E: IC5.13 (RIN1), U$1.P4.6 (6)
RXD1I: FTDI1.17 (DB1/RXD), IC5.12 (ROUT1)
RXD2E: IC6.13 (RIN1), U$1.P3.6 (6)
RXD2I: FTDI1.27 (DB1/RXD), IC6.12 (ROUT1)
RXD3E: IC7.13 (RIN1), U$1.P2.6 (6)
RXD3I: FTDI1.39 (DB1/RXD), IC7.12 (ROUT1)
RXD4E: IC8.13 (RIN1), U$1.P1.6 (6)
RXD4I: FTDI1.52 (DB1/RXD), IC8.12 (ROUT1)
TXD1E: IC5.14 (DOUT1), U$1.P4.3 (3)
TXD1I: FTDI1.16 (DB0/TXD), IC5.11 (DIN1)
TXD2E: IC6.14 (DOUT1), U$1.P3.3 (3)
TXD2I: FTDI1.26 (DB0/TXD), IC6.11 (DIN1)
TXD3E: IC7.14 (DOUT1), U$1.P2.3 (3)
TXD3I: FTDI1.38 (DB0/TXD), IC7.11 (DIN1)
TXD4E: IC8.14 (DOUT1), U$1.P1.3 (3)
TXD4I: FTDI1.48 (DB0/TXD), IC8.11 (DIN1)

Notes on the sheet:
Levelshifter
QUAD-USB-Serial Converter

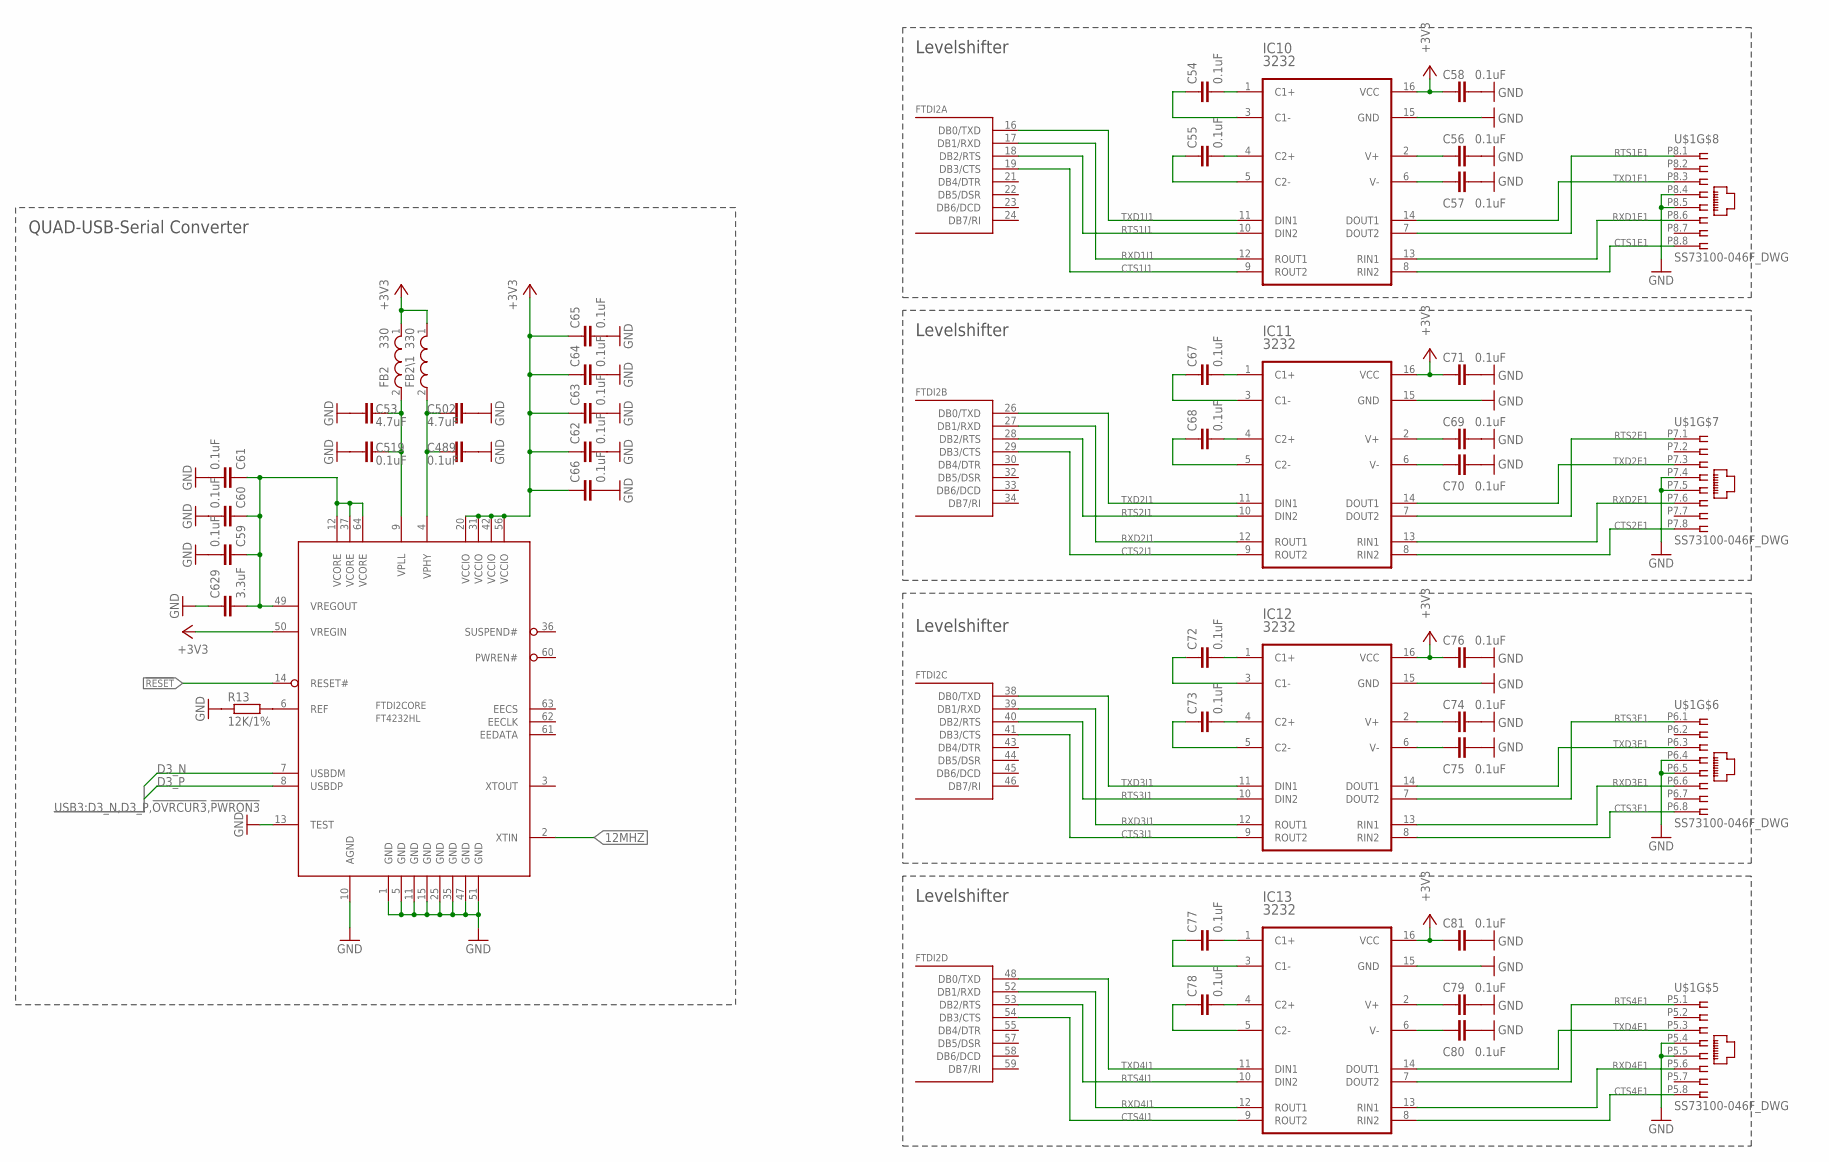
[picture p5: schematic freetserv.sch, sheet 5]

Parts:
C53, C502: 4.7uF; C0805; PARTNO 1276-2972-1-ND
C54, C55, C56, C57, C58, C59, C60, C61, C62, C63, C64, C65, C66, C67, C68, C69, C70, C71, C72, C73, C74, C75, C76, C77, C78, C79, C80, C81, C489, C519: 0.1uF; C0805; PARTNO 1276-1003-1-ND
C629: 3.3uF; C0805; PARTNO 445-7589-1-ND
FB2, FB2\1: 330; WE-KI_0805A; PARTNO 490-5988-1-ND
FTDI2: FT4232HL; LQFP64; PARTNO 768-1026-1-ND
IC10, IC11, IC12, IC13: 3232; SOP65P640X120-16N; PARTNO 296-19263-1-ND
R13: 12K/1%; R0805; PARTNO 311-12.0KCRCT-ND
U$1: SS73100-046F_DWG; SS73100-046F; PARTNO 380-1225-ND

Connections:
12MHZ: FTDI2.2 (XTIN); also elsewhere on the board
!RESET: FTDI2.14 (RESET#); also elsewhere on the board
+1V8-2: C59.1, C60.1, C61.1, C629.2, FTDI2.12 (VCORE), FTDI2.37 (VCORE), FTDI2.49 (VREGOUT), FTDI2.64 (VCORE)
+3V3: C58.2, C62.1, C63.1, C64.1, C65.1, C66.1, C71.2, C76.2, C81.2, FB2.1, FB2\1.1, FTDI2.20 (VCCIO), FTDI2.31 (VCCIO), FTDI2.42 (VCCIO), FTDI2.50 (VREGIN), FTDI2.56 (VCCIO), IC10.16 (VCC), IC11.16 (VCC), IC12.16 (VCC), IC13.16 (VCC); also elsewhere on the board
CTS1E1: IC10.8 (RIN2), U$1.P8.8 (8)
CTS1I1: FTDI2.19 (DB3/CTS), IC10.9 (ROUT2)
CTS2E1: IC11.8 (RIN2), U$1.P7.8 (8)
CTS2I1: FTDI2.29 (DB3/CTS), IC11.9 (ROUT2)
CTS3E1: IC12.8 (RIN2), U$1.P6.8 (8)
CTS3I1: FTDI2.41 (DB3/CTS), IC12.9 (ROUT2)
CTS4E1: IC13.8 (RIN2), U$1.P5.8 (8)
CTS4I1: FTDI2.54 (DB3/CTS), IC13.9 (ROUT2)
D3_N: FTDI2.7 (USBDM); also elsewhere on the board
D3_P: FTDI2.8 (USBDP); also elsewhere on the board
GND: C53.2, C56.1, C57.1, C58.1, C59.2, C60.2, C61.2, C62.2, C63.2, C64.2, C65.2, C66.2, C69.1, C70.1, C71.1, C74.1, C75.1, C76.1, C79.1, C80.1, C81.1, C489.2, C502.2, C519.2, C629.1, FTDI2.1 (GND), FTDI2.5 (GND), FTDI2.10 (AGND), FTDI2.11 (GND), FTDI2.13 (TEST), FTDI2.15 (GND), FTDI2.25 (GND), FTDI2.35 (GND), FTDI2.47 (GND), FTDI2.51 (GND), IC10.15 (GND), IC11.15 (GND), IC12.15 (GND), IC13.15 (GND), R13.1, U$1.P5.4 (4), U$1.P5.5 (5), U$1.P6.4 (4), U$1.P6.5 (5), U$1.P7.4 (4), U$1.P7.5 (5), U$1.P8.4 (4), U$1.P8.5 (5); also elsewhere on the board
unnamed: FTDI2.6 (REF), R13.2
unnamed: C54.2, IC10.1 (C1+)
unnamed: C54.1, IC10.3 (C1-)
unnamed: C55.2, IC10.4 (C2+)
unnamed: C55.1, IC10.5 (C2-)
unnamed: C56.2, IC10.2 (V+)
unnamed: C57.2, IC10.6 (V-)
unnamed: C67.2, IC11.1 (C1+)
unnamed: C67.1, IC11.3 (C1-)
unnamed: C68.2, IC11.4 (C2+)
unnamed: C68.1, IC11.5 (C2-)
unnamed: C69.2, IC11.2 (V+)
unnamed: C70.2, IC11.6 (V-)
unnamed: C72.2, IC12.1 (C1+)
unnamed: C72.1, IC12.3 (C1-)
unnamed: C73.2, IC12.4 (C2+)
unnamed: C73.1, IC12.5 (C2-)
unnamed: C74.2, IC12.2 (V+)
unnamed: C75.2, IC12.6 (V-)
unnamed: C77.1, IC13.3 (C1-)
unnamed: C78.2, IC13.4 (C2+)
unnamed: C78.1, IC13.5 (C2-)
unnamed: C79.2, IC13.2 (V+)
unnamed: C80.2, IC13.6 (V-)
unnamed: C489.1, C502.1, FB2\1.2, FTDI2.4 (VPHY)
unnamed: C53.1, C519.1, FB2.2, FTDI2.9 (VPLL)
unnamed: C77.2, IC13.1 (C1+)
RTS1E1: IC10.7 (DOUT2), U$1.P8.1 (1)
RTS1I1: FTDI2.18 (DB2/RTS), IC10.10 (DIN2)
RTS2E1: IC11.7 (DOUT2), U$1.P7.1 (1)
RTS2I1: FTDI2.28 (DB2/RTS), IC11.10 (DIN2)
RTS3E1: IC12.7 (DOUT2), U$1.P6.1 (1)
RTS3I1: FTDI2.40 (DB2/RTS), IC12.10 (DIN2)
RTS4E1: IC13.7 (DOUT2), U$1.P5.1 (1)
RTS4I1: FTDI2.53 (DB2/RTS), IC13.10 (DIN2)
RXD1E1: IC10.13 (RIN1), U$1.P8.6 (6)
RXD1I1: FTDI2.17 (DB1/RXD), IC10.12 (ROUT1)
RXD2E1: IC11.13 (RIN1), U$1.P7.6 (6)
RXD2I1: FTDI2.27 (DB1/RXD), IC11.12 (ROUT1)
RXD3E1: IC12.13 (RIN1), U$1.P6.6 (6)
RXD3I1: FTDI2.39 (DB1/RXD), IC12.12 (ROUT1)
RXD4E1: IC13.13 (RIN1), U$1.P5.6 (6)
RXD4I1: FTDI2.52 (DB1/RXD), IC13.12 (ROUT1)
TXD1E1: IC10.14 (DOUT1), U$1.P8.3 (3)
TXD1I1: FTDI2.16 (DB0/TXD), IC10.11 (DIN1)
TXD2E1: IC11.14 (DOUT1), U$1.P7.3 (3)
TXD2I1: FTDI2.26 (DB0/TXD), IC11.11 (DIN1)
TXD3E1: IC12.14 (DOUT1), U$1.P6.3 (3)
TXD3I1: FTDI2.38 (DB0/TXD), IC12.11 (DIN1)
TXD4E1: IC13.14 (DOUT1), U$1.P5.3 (3)
TXD4I1: FTDI2.48 (DB0/TXD), IC13.11 (DIN1)

Notes on the sheet:
Levelshifter
QUAD-USB-Serial Converter

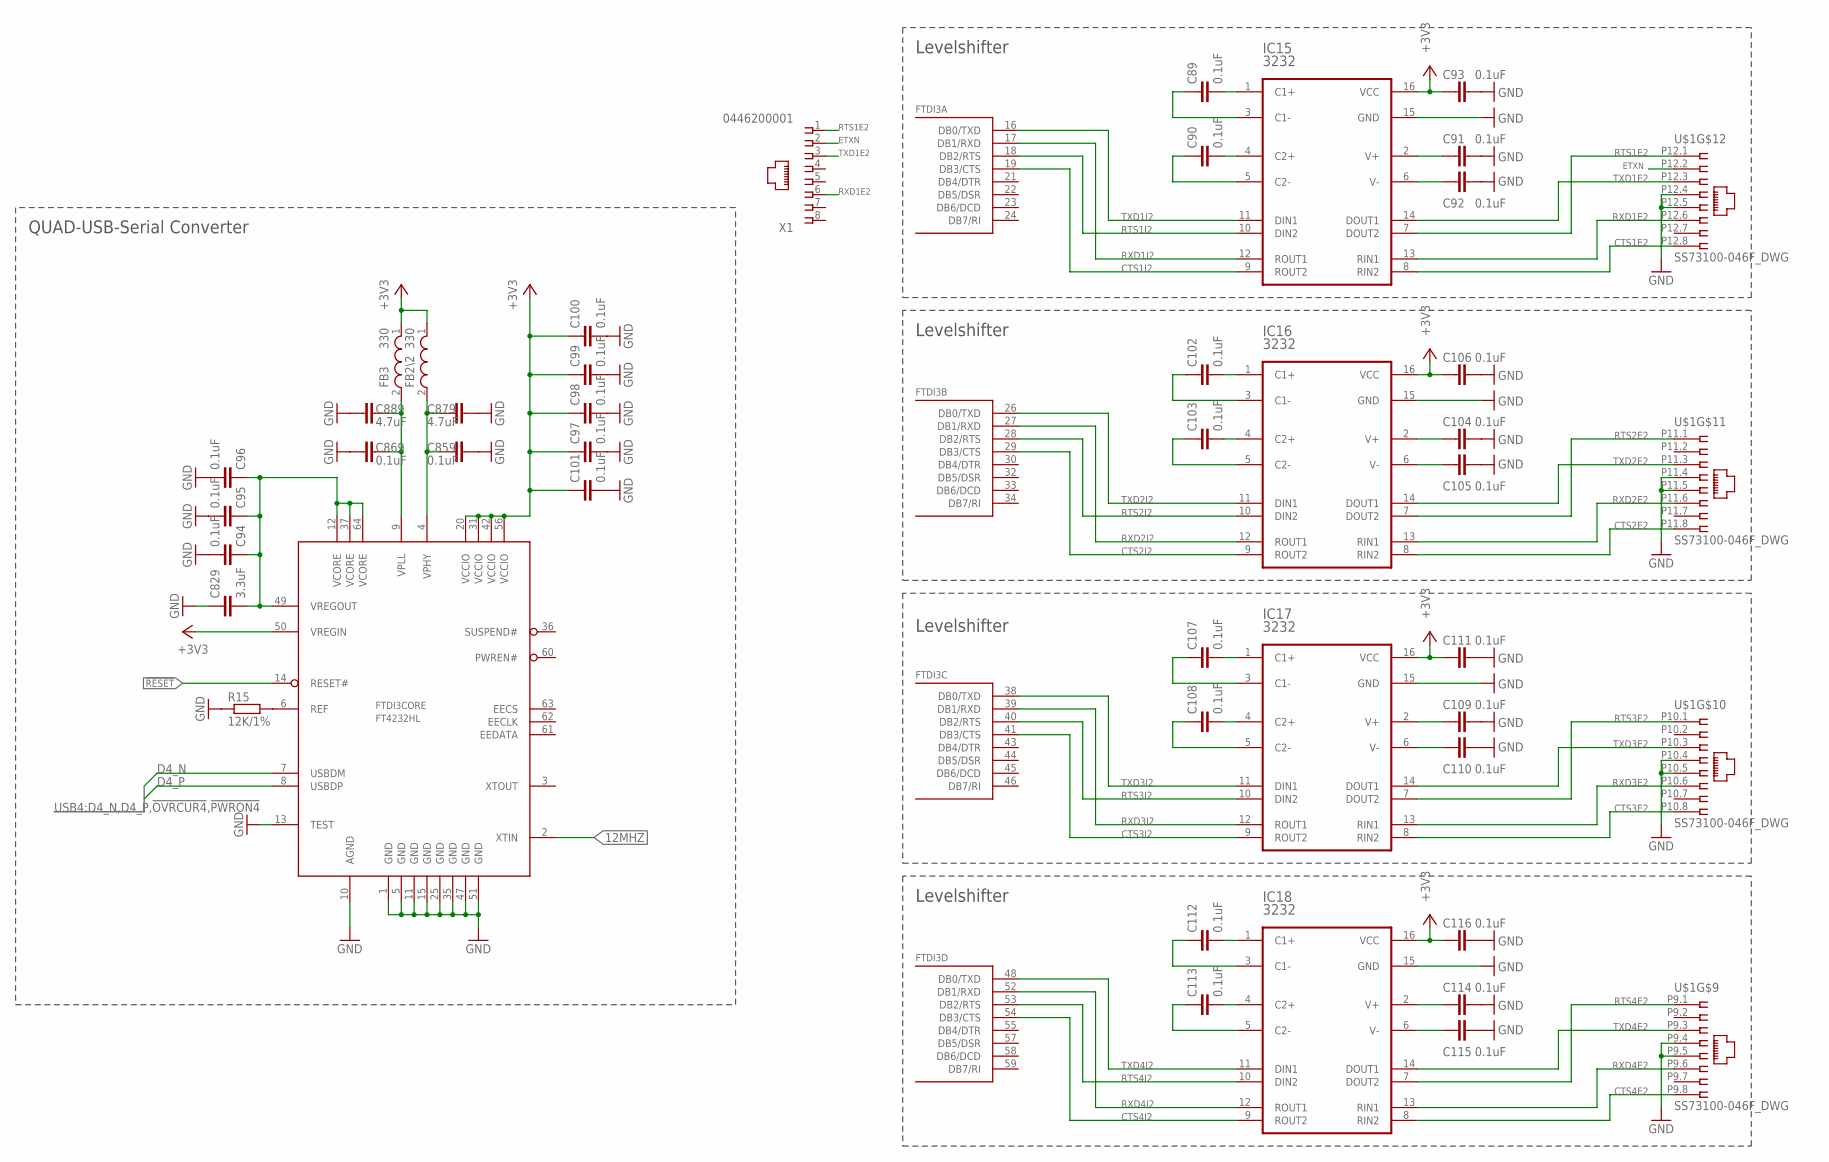
[picture p6: schematic freetserv.sch, sheet 6]

Parts:
C89, C90, C91, C92, C93, C94, C95, C96, C97, C98, C99, C100, C101, C102, C103, C104, C105, C106, C107, C108, C109, C110, C111, C112, C113, C114, C115, C116, C859, C869: 0.1uF; C0805; PARTNO 1276-1003-1-ND
C829: 3.3uF; C0805; PARTNO 445-7589-1-ND
C879, C889: 4.7uF; C0805; PARTNO 1276-2972-1-ND
FB2\2, FB3: 330; WE-KI_0805A; PARTNO 490-5988-1-ND
FTDI3: FT4232HL; LQFP64; PARTNO 768-1026-1-ND
IC15, IC16, IC17, IC18: 3232; SOP65P640X120-16N; PARTNO 296-19263-1-ND
R15: 12K/1%; R0805; PARTNO 311-12.0KCRCT-ND
U$1: SS73100-046F_DWG; SS73100-046F; PARTNO 380-1225-ND
X1: 0446200001

Connections:
12MHZ: FTDI3.2 (XTIN); also elsewhere on the board
!RESET: FTDI3.14 (RESET#); also elsewhere on the board
+1V8-3: C94.1, C95.1, C96.1, C829.2, FTDI3.12 (VCORE), FTDI3.37 (VCORE), FTDI3.49 (VREGOUT), FTDI3.64 (VCORE)
+3V3: C93.2, C97.1, C98.1, C99.1, C100.1, C101.1, C106.2, C111.2, C116.2, FB2\2.1, FB3.1, FTDI3.20 (VCCIO), FTDI3.31 (VCCIO), FTDI3.42 (VCCIO), FTDI3.50 (VREGIN), FTDI3.56 (VCCIO), IC15.16 (VCC), IC16.16 (VCC), IC17.16 (VCC), IC18.16 (VCC); also elsewhere on the board
CTS1E2: IC15.8 (RIN2), U$1.P12.8 (8)
CTS1I2: FTDI3.19 (DB3/CTS), IC15.9 (ROUT2)
CTS2E2: IC16.8 (RIN2), U$1.P11.8 (8)
CTS2I2: FTDI3.29 (DB3/CTS), IC16.9 (ROUT2)
CTS3E2: IC17.8 (RIN2), U$1.P10.8 (8)
CTS3I2: FTDI3.41 (DB3/CTS), IC17.9 (ROUT2)
CTS4E2: IC18.8 (RIN2), U$1.P9.8 (8)
CTS4I2: FTDI3.54 (DB3/CTS), IC18.9 (ROUT2)
D4_N: FTDI3.7 (USBDM); also elsewhere on the board
D4_P: FTDI3.8 (USBDP); also elsewhere on the board
ETXN: U$1.P12.2 (2), X1.2 (7)
GND: C91.1, C92.1, C93.1, C94.2, C95.2, C96.2, C97.2, C98.2, C99.2, C100.2, C101.2, C104.1, C105.1, C106.1, C109.1, C110.1, C111.1, C114.1, C115.1, C116.1, C829.1, C859.2, C869.2, C879.2, C889.2, FTDI3.1 (GND), FTDI3.5 (GND), FTDI3.10 (AGND), FTDI3.11 (GND), FTDI3.13 (TEST), FTDI3.15 (GND), FTDI3.25 (GND), FTDI3.35 (GND), FTDI3.47 (GND), FTDI3.51 (GND), IC15.15 (GND), IC16.15 (GND), IC17.15 (GND), IC18.15 (GND), R15.1, U$1.P9.4 (4), U$1.P9.5 (5), U$1.P10.4 (4), U$1.P10.5 (5), U$1.P11.4 (4), U$1.P11.5 (5), U$1.P12.4 (4), U$1.P12.5 (5); also elsewhere on the board
unnamed: FTDI3.6 (REF), R15.2
unnamed: C859.1, C879.1, FB2\2.2, FTDI3.4 (VPHY)
unnamed: C869.1, C889.1, FB3.2, FTDI3.9 (VPLL)
unnamed: C89.2, IC15.1 (C1+)
unnamed: C89.1, IC15.3 (C1-)
unnamed: C90.2, IC15.4 (C2+)
unnamed: C90.1, IC15.5 (C2-)
unnamed: C91.2, IC15.2 (V+)
unnamed: C92.2, IC15.6 (V-)
unnamed: C102.2, IC16.1 (C1+)
unnamed: C102.1, IC16.3 (C1-)
unnamed: C103.2, IC16.4 (C2+)
unnamed: C103.1, IC16.5 (C2-)
unnamed: C104.2, IC16.2 (V+)
unnamed: C105.2, IC16.6 (V-)
unnamed: C107.2, IC17.1 (C1+)
unnamed: C107.1, IC17.3 (C1-)
unnamed: C108.2, IC17.4 (C2+)
unnamed: C108.1, IC17.5 (C2-)
unnamed: C109.2, IC17.2 (V+)
unnamed: C110.2, IC17.6 (V-)
unnamed: C112.2, IC18.1 (C1+)
unnamed: C112.1, IC18.3 (C1-)
unnamed: C113.2, IC18.4 (C2+)
unnamed: C113.1, IC18.5 (C2-)
unnamed: C114.2, IC18.2 (V+)
unnamed: C115.2, IC18.6 (V-)
RTS1E2: IC15.7 (DOUT2), U$1.P12.1 (1), X1.1 (8)
RTS1I2: FTDI3.18 (DB2/RTS), IC15.10 (DIN2)
RTS2E2: IC16.7 (DOUT2), U$1.P11.1 (1)
RTS2I2: FTDI3.28 (DB2/RTS), IC16.10 (DIN2)
RTS3E2: IC17.7 (DOUT2), U$1.P10.1 (1)
RTS3I2: FTDI3.40 (DB2/RTS), IC17.10 (DIN2)
RTS4E2: IC18.7 (DOUT2), U$1.P9.1 (1)
RTS4I2: FTDI3.53 (DB2/RTS), IC18.10 (DIN2)
RXD1E2: IC15.13 (RIN1), U$1.P12.6 (6), X1.6 (3)
RXD1I2: FTDI3.17 (DB1/RXD), IC15.12 (ROUT1)
RXD2E2: IC16.13 (RIN1), U$1.P11.6 (6)
RXD2I2: FTDI3.27 (DB1/RXD), IC16.12 (ROUT1)
RXD3E2: IC17.13 (RIN1), U$1.P10.6 (6)
RXD3I2: FTDI3.39 (DB1/RXD), IC17.12 (ROUT1)
RXD4E2: IC18.13 (RIN1), U$1.P9.6 (6)
RXD4I2: FTDI3.52 (DB1/RXD), IC18.12 (ROUT1)
TXD1E2: IC15.14 (DOUT1), U$1.P12.3 (3), X1.3 (6)
TXD1I2: FTDI3.16 (DB0/TXD), IC15.11 (DIN1)
TXD2E2: IC16.14 (DOUT1), U$1.P11.3 (3)
TXD2I2: FTDI3.26 (DB0/TXD), IC16.11 (DIN1)
TXD3E2: IC17.14 (DOUT1), U$1.P10.3 (3)
TXD3I2: FTDI3.38 (DB0/TXD), IC17.11 (DIN1)
TXD4E2: IC18.14 (DOUT1), U$1.P9.3 (3)
TXD4I2: FTDI3.48 (DB0/TXD), IC18.11 (DIN1)

Notes on the sheet:
Levelshifter
QUAD-USB-Serial Converter

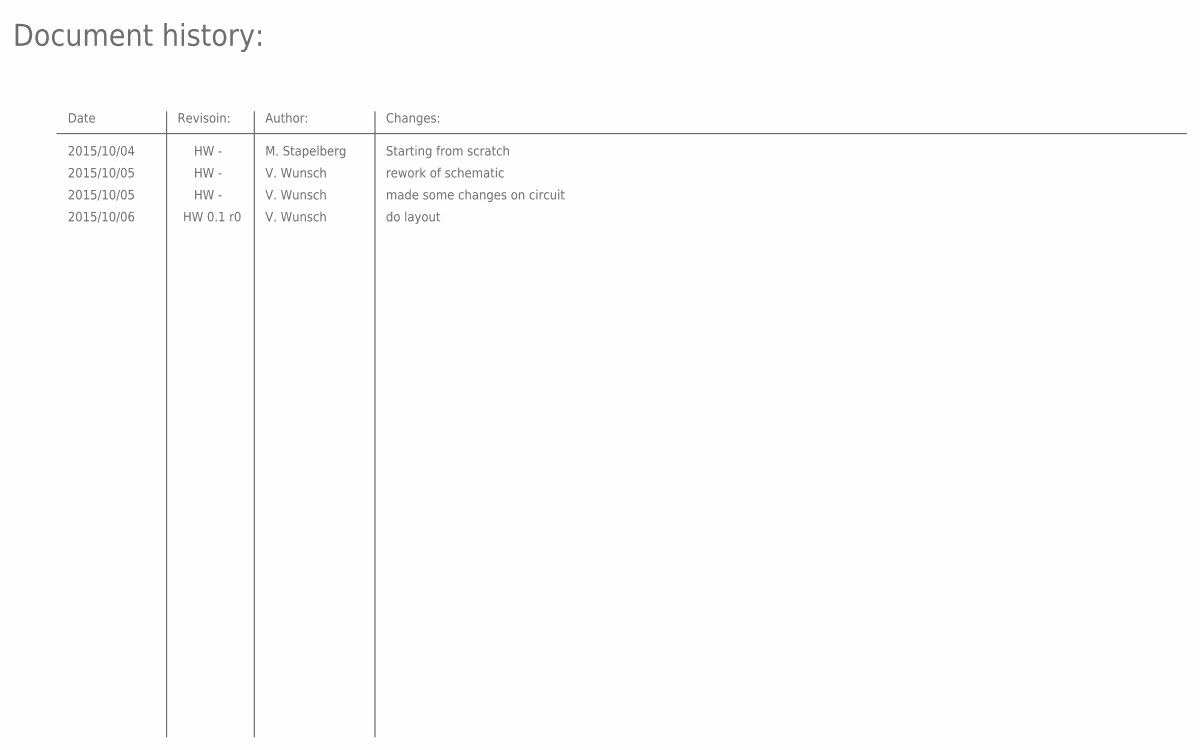
[picture p7: schematic freetserv.sch, sheet 7]

Notes on the sheet:
Revisoin:
Document history:
Date
Author:
2015/10/05
2015/10/04
HW -
Changes:
M. Stapelberg
V. Wunsch
Starting from scratch
rework of schematic
made some changes on circuit
do layout
2015/10/06
HW 0.1 r0
