freetserv/freetserv/freetserv.brd

## EAGLE design freetserv.brd (continued)

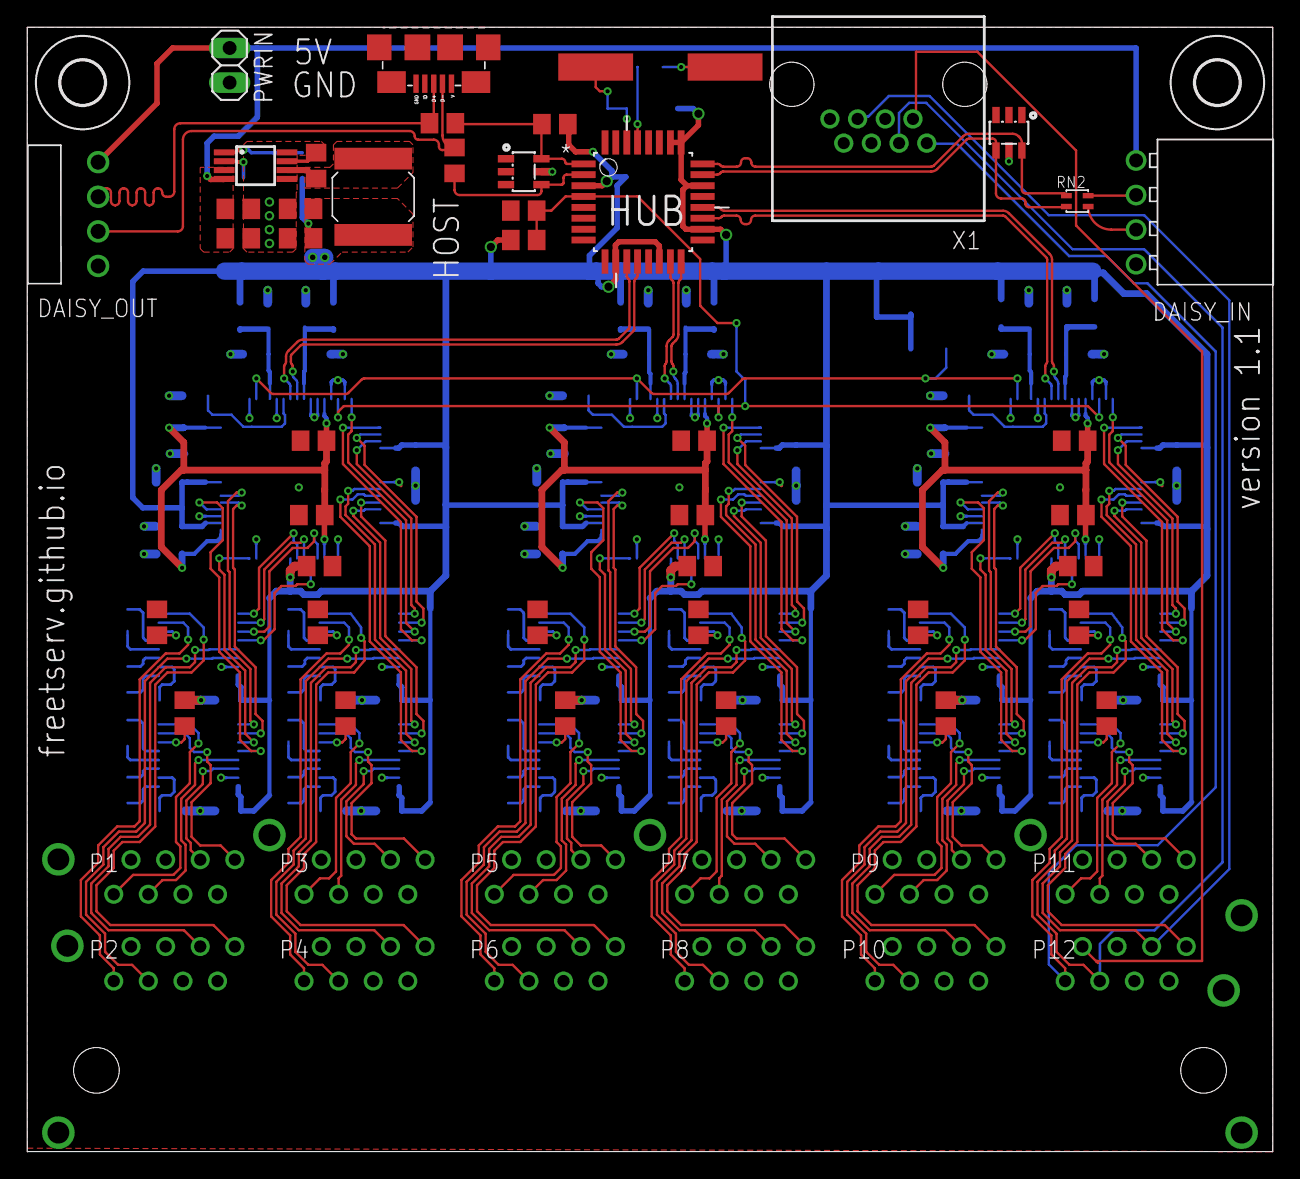
[picture p8: board freetserv.brd from above]

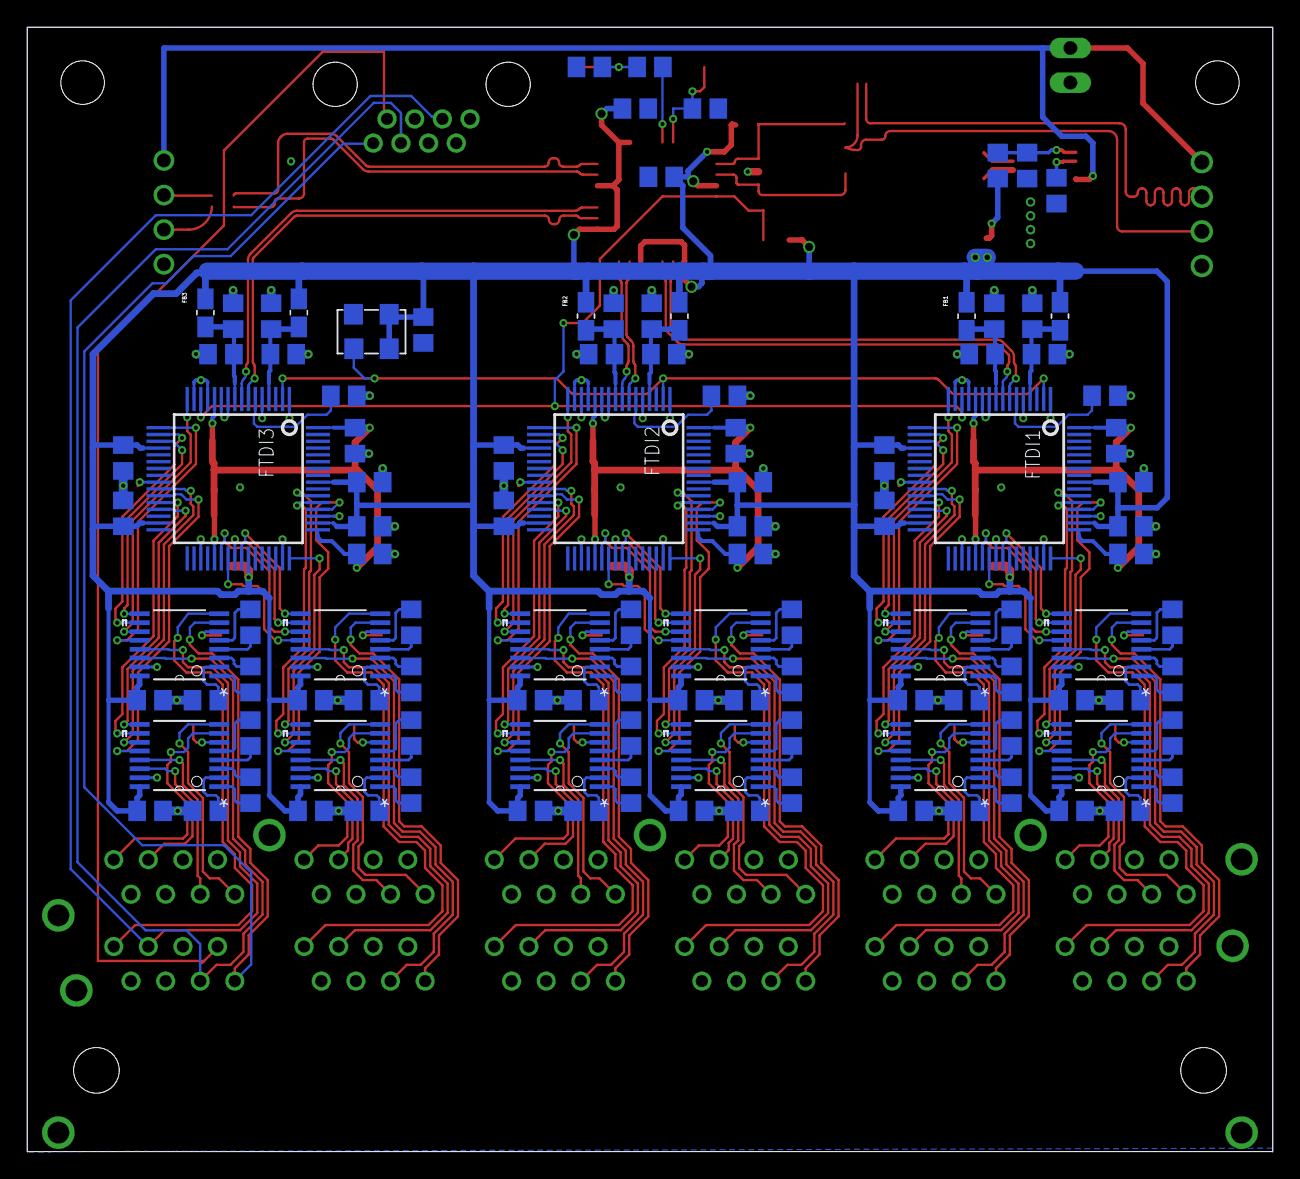
[picture p9: board freetserv.brd from below]

Board: 2 copper layers, 91.4 x 82.5 mm, 158 parts (112 on the bottom side), 207 nets.
