freetserv/freetserv/(commit log)

2015-09-01 Initial commit, schematics mostly complete, layout still not done
    [freetserv.brd, freetserv.sch]
2015-09-01 layouted power-related part, added more MAX3232 drivers to schematics
    [freetserv.brd, freetserv.sch]
2015-09-01 layout all MAX3232s, position power distribution
    [freetserv.brd, freetserv.sch]
2015-09-02 routed the MAX3232 and FT4232HL within final space constraints
    [freetserv.brd, freetserv.sch]
2015-09-02 use TUSB2046B (+ additional USB port), route both
    Warnings need to be addressed, but the bulk of the routing should now be
    done.
    [freetserv.brd, freetserv.sch]
2015-09-03 hook up the second USB port to the SN75240 as well
    [freetserv.brd, freetserv.sch]
2015-09-03 make differential pairs more symmetric, move vias close to TUSB
    also add the recommended 0.1uF capacitor close to the power pin
    [freetserv.brd, freetserv.sch]
2015-09-03 fix GND plane vias for power USB ports
    [freetserv.brd]
2015-09-03 fix all clearance DRC warnings (with smart-prototyping DRU file)
    [freetserv.brd]
2015-09-03 make all vias at least 12mil (minimum smart-prototyping size)
    [freetserv.brd]
2015-09-03 address all DRC warnings
    [freetserv.brd, freetserv.sch]
2015-09-03 add ground planes underneath the crystals
    [freetserv.brd]
2015-09-03 route the USB data tracks underneath the 3.3V
    That way, we have identical distortions on both lines, and they are
    further away from the voltage regulator.
    [freetserv.brd]
2015-09-03 add labels to the USB ports
    [freetserv.brd]
2015-09-03 add .gitignore to ignore EAGLE’s temporary files
2015-09-03 add gerber files for smart-prototyping.com
    [freetserv.GBL, freetserv.GBO, freetserv.GBP, freetserv.GBS, freetserv.GTL, freetserv.GTO, freetserv.GTP, freetserv.GTS]
2015-09-22 renamed L1, L2 to FERRITE1, FERRITE2, added values
    [freetserv.brd, freetserv.sch]
2015-09-26 Bugfix: add 1.5kΩ resistor to USB D+ to host
    This is necessary for the host to recognize that a USB device was
    plugged in. Without this resistor, nothing happens when you connect the
    board to a computer.
    [freetserv.brd, freetserv.sch]
2015-09-26 Replace all 100nF capacitors with 0.1uF (which is the same)
    Since capacitors are labelled as 0.1uF, this makes it more clear which
    part goes where.
    fixes #8
    [freetserv.brd, freetserv.sch]
2015-09-26 use 18pF capacitors to match the crystals
    [freetserv.brd, freetserv.sch]
2015-09-26 assign part numbers for almost all parts
    The remaining parts are possibly subject to change.
    This was done using the bom-ex ULP:
    http://www.cadsoftusa.com/downloads/file/bom-ex164.zip
    fixes #10
    fixes #13
    fixes #14
    [freetserv.brd, freetserv.sch]
2015-09-26 rename VCC/VCC_3.3V to +5V and +3V3, use appropriate supply pins
    Also disconnect the power supply part from the USB hub so that we have
    an easier time adding the R/C circuit.
    [freetserv.brd, freetserv.sch]
2015-09-26 replace volt supervisor IC with R/C circuit
    Not yet routed to the FTDI, because that area still needs some
    re-routing anyway.
    fixes #5
    [freetserv.brd, freetserv.sch]
2015-09-26 increase pad sizes of U1
    fixes #3
    [freetserv.brd, freetserv.sch]
2015-09-26 increase FTDI pad size
    Will need re-routing, but the FTDI part will need to be redone anyway
    due to issue #11.
    fixes #7
    [freetserv.brd, freetserv.sch]
2015-09-26 increase pad size of FERRITE1,2
    fixes #9
    [freetserv.brd, freetserv.sch]
2015-09-26 add circle to pin 1 for the MAX3232
    Also use the correct IC (E variant for ESD protection) and rename the
    ICs properly (DRIVER → DRV so that the name fits, suffix 0A-0D like the
    FTDI outputs).
    see issue #2
    [freetserv.brd, freetserv.sch]
2015-09-26 add circle to pin 1 of the TUSB2046, increase pad size while at it
    fixes #2
    [freetserv.brd, freetserv.sch]
2015-09-28 add capacitors for VCORE/VIO
    fixes #12
    [freetserv.brd, freetserv.sch]
2015-09-28 move 100nF capacitors closer to VPHY/VPLL
    fixes #11
    [freetserv.brd]
2015-09-28 re-route USB as differential pairs with 45° traces
    fixes #1
    [freetserv.brd]
2015-09-28 add 27Ω resistors to host D+/D- port for impedance matching
    fixes #6
    [freetserv.brd, freetserv.sch]
2015-09-28 fix remaining DRC errors
    [freetserv.brd]
2015-09-28 fix remaining airwires
    [freetserv.brd]
2015-09-28 add remaining part numbers
    [freetserv.brd, freetserv.sch]
2015-09-28 swap all X5R capacitors with X7R ones
    [freetserv.brd, freetserv.sch]
2015-09-28 add BOM to git
2015-10-05 wire up the 12-port 8P8C device
    [freetserv.brd, freetserv.sch]
2015-10-06 wire up a serial port
    [freetserv.brd, freetserv.sch]
2015-10-06 Bugfix: disconnect EEDATA/EECS from GND (Thanks Volker!)
    With this fix, the FTDI converter is recognized by the host \o/
    [freetserv.brd, freetserv.sch]
2015-11-08 Volker re-organized the schematics
    [freetserv.brd, freetserv.sch]
2015-11-08 Volker re-routed the FTDI (work-in-progress)
    [freetserv.brd, freetserv.sch]
2015-11-08 Volker finished the FTDI routing, duplicated it
    [freetserv.brd, freetserv.sch]
2015-11-08 replace micro-USB power input with 2-pin header
    [freetserv.brd, freetserv.sch]
2015-11-08 add daisy-chain input/output socket/pin headers
    [freetserv.brd, freetserv.sch]
2015-11-08 drc: fix via size, width on bottom layer
    [freetserv.brd, freetserv.sch]
2015-11-08 fix drc warnings in power supply
    [freetserv.brd]
2015-11-08 wire up power supply
    [freetserv.brd]
2015-11-08 wire up USB hub
    [freetserv.brd]
2015-11-08 fix all airwires except from the USB differential pair
    [freetserv.brd]
2015-11-08 wire up DAISY_OUT
    [freetserv.brd]
2015-11-08 add tPlace documentation (port descriptions, version)
    [freetserv.brd]
2015-11-08 re-route DAISY_OUT’s USB traces
    [freetserv.brd, freetserv.sch]
2015-11-08 update part numbers and BOM
    [freetserv.brd, freetserv.sch]
2015-11-08 fix clearance DRC error
    [freetserv.brd]
2015-11-08 update gerber files for version 1.0
    [freetserv.GBL, freetserv.GBO, freetserv.GBP, freetserv.GBS, freetserv.GTL, freetserv.GTO, freetserv.GTP, freetserv.GTS]
2015-11-09 import Schaeffer AG’s “Side Profile 1”
    See http://www.schaeffer-ag.de/en/products/housings/
    The file was downloaded from
    http://www.schaeffer-ag.de/fileadmin/user_upload/Geh%C3%A4use/Zips/Side-profile-1.zip
2015-11-09 reduce depth to 150mm
2015-11-09 add M2.5 drill holes for the freetserv PCBs
2015-11-09 add holes for the 8P8C connectors
2015-11-09 add mounting holes for the raspberry pi
2015-11-09 add mount holes for the PSU
2015-11-09 add hole for the power plug
2015-11-09 added fan to back plate
2015-11-20 swap crystal part number to FOX924B-12.000 (old one was too big)
    fixes #17
    [freetserv.brd, freetserv.sch]
2015-11-21 back plate: replace 40x40mm fan hole with 30x30mm fan hole
2015-11-21 silkscreen: move labels so they are clearly visible
    I didn’t enable vector font rendering previously, so on the manufactured
    PCB, some labels are cut off.
    [freetserv.brd, freetserv.sch]
2015-11-21 reduce pin 1 circle size on the MAX3232 ICs
    [freetserv.brd]
2015-11-21 replace M2.5 drill holes with M3 for freetserv PCBs
    …so that they match the drill holes in the PCB, which are M3.
2015-11-21 split top+bottom into separate top and bottom files
    The top plate does not need all the drill holes (cheaper/cleaner).
2015-11-22 bottom: duplicate M3 drill holes, so there are 2 positions for the PSU
    We’ll see which one works better. Also move the raspberry pi a bit more
    to the right, so that there is some space between the PSU and the
    raspberry pi.
2015-11-27 freetserv.sch: fix broken forward/backward-annotation
    caused by commit 1419bf359ab668af9a7b72a02ff99d9803568ba5, where I
    forgot to also commit the changes to the .sch file.
    [freetserv.sch]
2015-11-27 add eagle project file stub
    This way, after cloning freetserv, you can add the path to
    Options → Directories in eagle.
2015-11-27 bottom: move PSU and raspberry pi a little to the right
    The old position obscured the fan and the micro USB port.
2015-11-27 top/bottom: add 2mm of material
    …so that the plates can slide into the front plate.
2015-11-27 move raspberry pi even further to the right
    This way, we have a chance to use all 3 angles for the case.
2015-11-27 front: move slide-in space by 1mm each to fit the side profile
2015-11-27 front: fix power inlet cutout dimensions
2015-11-27 front: add labels for power inlet and ports
2015-11-27 enlarge bottom/top plate by 2cm
    This gives us enough space to, if we have to, connect each individual
    PCB via USB to the raspberry pi. It also makes sure that the power
    supply has the recommended safety distance of 4mm on all sides. Further,
    we should be able to use all the angles in the case now.
2015-11-27 bottom: move PCB mounting holes to the left
2015-11-27 front: add 5mm hole for power LED
    this concludes the changes for revision 2 of the case
    fixes #20
2015-11-29 Bugfix: pin 4 of DAISY_IN was not properly connected to GND
    [freetserv.brd, freetserv.sch]
2015-11-30 enable alwaysvectorfont
    [freetserv.brd]
2015-11-30 clean up silk screen on the top layer
    see issue #24
    [freetserv.brd, freetserv.sch]
2015-11-30 clean up silk screen on the bottom layer
    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
    [freetserv.brd, freetserv.sch]
2015-11-30 import smart-prototyping’s EagleCAM.cam
2015-11-30 increase ferrite pad sizes for easier hand-soldering
    fixes #19
    [freetserv.brd, freetserv.sch]
2015-11-30 swap oscillator with ASFL1-12.000MHZ-EK-T
    The new one has little holes in the sides, making hand-soldering
    possible.
    see #18
    [freetserv.brd, freetserv.sch]
2015-11-30 increase pad size of the oscillator for easier hand-soldering
    fixes #18
    [freetserv.brd, freetserv.sch]
2015-11-30 bump PCB version to 1.1
    [freetserv.brd]
2015-11-30 update gerber files for version 1.1
    [freetserv.GBL, freetserv.GBO, freetserv.GBP, freetserv.GBS, freetserv.GTL, freetserv.GTO, freetserv.GTP, freetserv.GTS]
2015-12-07 top/bottom/back: remove middle housing bracket holes
    These cannot be used because of the PSU, so there’s no point in keeping
    them around.
    fixes #28
2015-12-07 top plate: place cut-out on the back side
    fixes #27
2015-12-10 front: undo moving slide-in cutout
    Turns out I misunderstood how the top/bottom plate are supposed to slide
    into the case.
    This reverts 53688bf7ae2e356861aa1cd1da1d178a7d0fdc75
    issue #33 is related
2015-12-10 top: place cut-outs on the front side again
    This reverts commit f9b77c2f7ac78431a26ba20b34ed945c98553213
    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
2015-12-10 bottom: fix cutouts and sink holes (need to go onto the back side)
    fixes #33
2015-12-10 front: allow for both, snap-in and screw-mounted power inlets
    fixes #29
2015-12-10 front: add another 5mm LED hole for a watchdog LED, add labels
    issue #30 is related
2015-12-10 Add watchdog which toggles GPIO4 every second.
    A +3.3V LED (with appropriate resistor to limit the current to 10mA) can
    be connected to GPIO4 and serve as a watchdog LED, i.e. to indicate the
    device is still working.
2015-12-12 add trivial LED PCB, change front plate accordingly
    You can solder the two LEDs (1497-1017-ND on digikey) onto the PCB, then
    mount the PCB onto the front plate using two M3 screws (335-1150-ND on
    digikey), possibly with one or two fasteners (H767-ND on digikey).
    This change makes all parts use screws (the LED was glued to the front
    plate previously).
    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
    [leds.GBL, leds.GBO, leds.GBP, leds.GBS, leds.GTL, leds.GTO, leds.GTP, leds.GTS]
2015-12-12 bottom plate: use threaded inserts instead of threaded holes
    This makes the bottom plate 10€ more expensive, but frees us from
    hand-shortening M3 hex standoffs (because they are not available with
    the length we need them in).
2015-12-13 front: fix PCB LED dimensions, fix power inlet cutout
    The power inlet cutout is for the
    Delta Electronics 03GEEW3E (Digi-Key 1144-1024-ND)
2016-03-03 tweaked by jaredmauch
    [freetserv.brd, freetserv.sch]
2016-04-04 front plate: move LEDs .5mm to the top, 1mm to the right
    That way, they don’t conflict with the PCB.
2016-10-19 Update text-format BOM
    fixes #41
